YCSRobotics/CAD-66-ROBOT-2018/Reference Pics/SF1.png

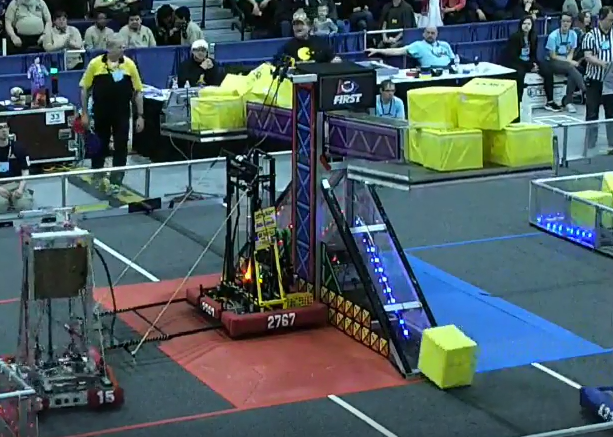
Reference Pics/SF1.png
