YCSRobotics/CAD-66-ROBOT-2018/Reference Pics/SF2.png

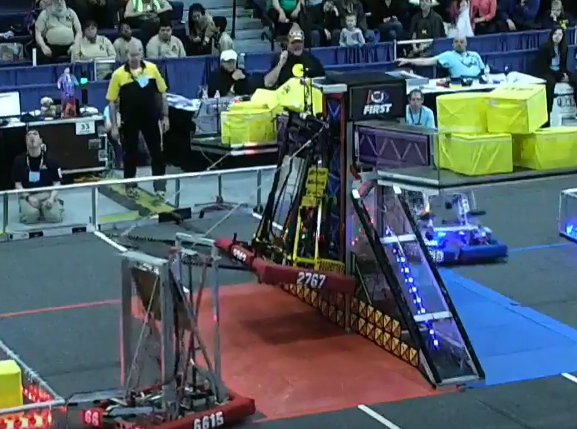
Reference Pics/SF2.png
