YCSRobotics/CAD-66-ROBOT-2018/Part Drawings/All Part Drawings.pdf

# Elevator Base

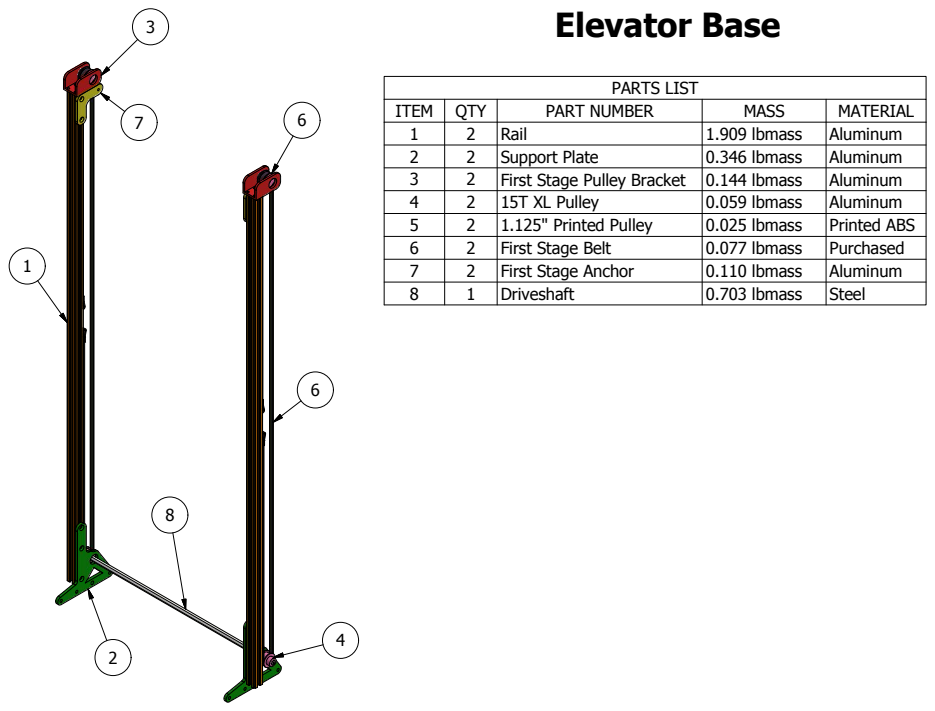
[picture p23: page 1]
PARTS LIST; ITEM; QTY; PART NUMBER; MASS; MATERIAL; Rail; 1.909 lbmass; Aluminum; Support Plate; 0.346 lbmass; First Stage Pulley Bracket; 0.144 lbmass; 15T XL Pulley; 0.059 lbmass; 1.125" Printed Pulley; 0.025 lbmass; Printed ABS; First Stage Belt; 0.077 lbmass; Purchased; First Stage Anchor; 0.110 lbmass; Driveshaft; 0.703 lbmass; Steel

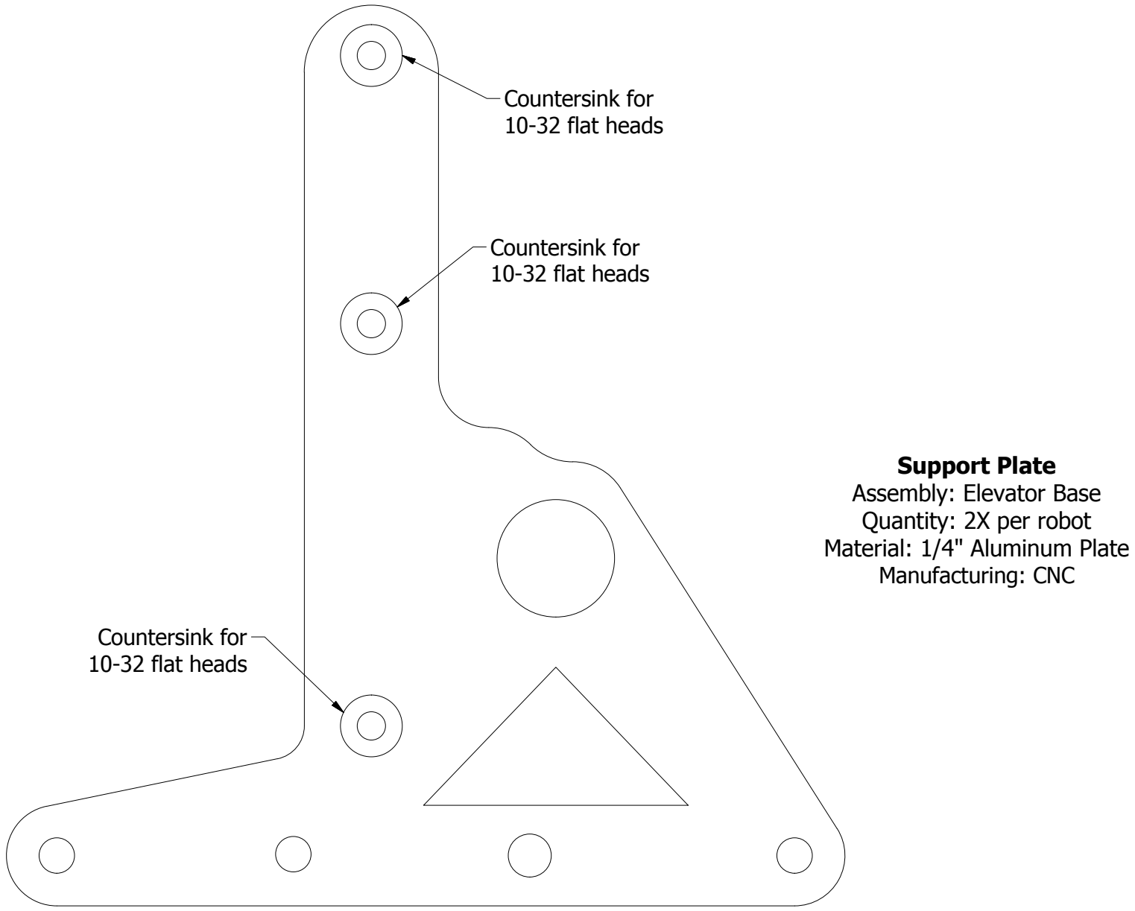
[picture p24: figure]
Countersink for 10-32 flat heads; Support Plate Assembly: Elevator Base Quantity: 2X per robot Material: 1/4" Aluminum Plate Manufacturing: CNC

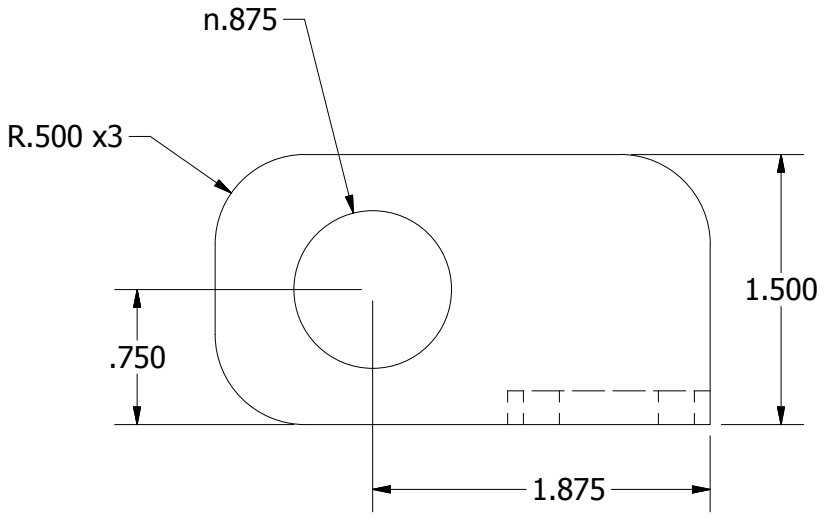
[picture p25: figure]

1.125
3/16 or 1/4

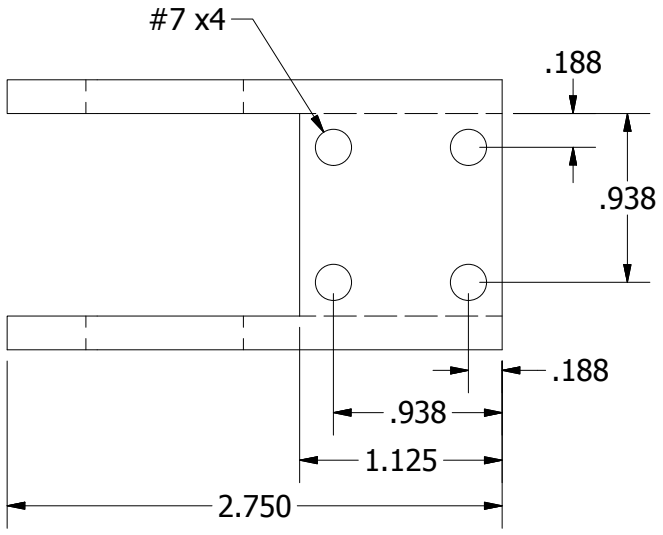
[picture p26: figure]

First Stage Pulley Bracket Assembly: Elevator Base
Quantity: 2X per robot
Material: 3/16" by 1.5" C Channel or 1/4" by 1.625" C Channel Manufacturing: Mill

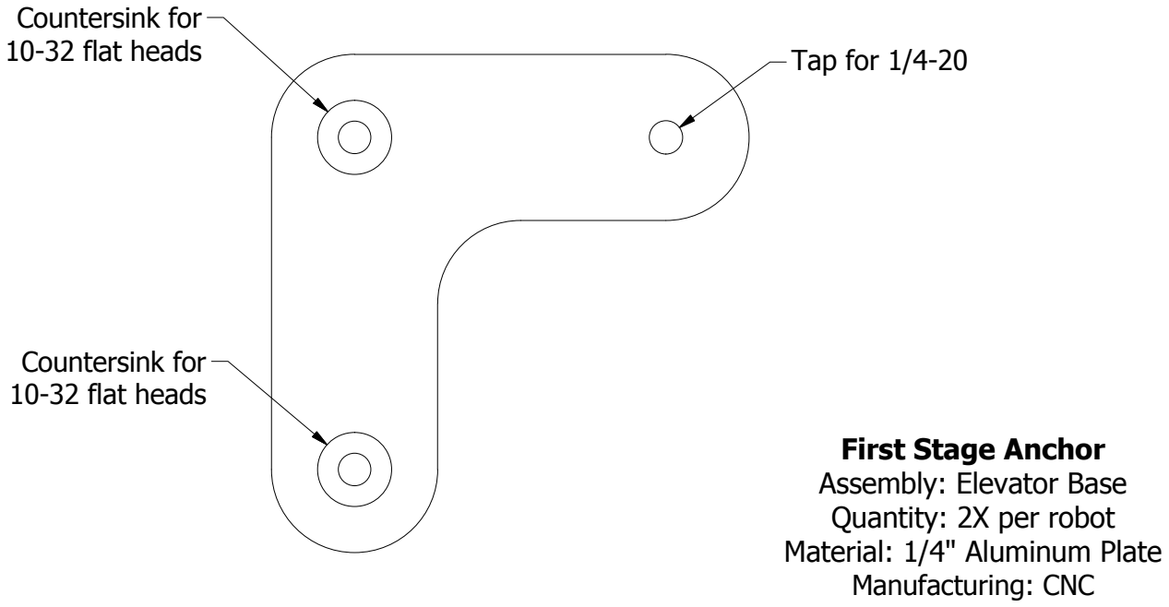
[picture p27: figure]
Countersink for 10-32 flat heads; Tap for 1/4-20; First Stage Anchor Assembly: Elevator Base Quantity: 2X per robot Material: 1/4" Aluminum Plate Manufacturing: CNC

.375 21.750

Driveshaft
Assembly: Elevator Base
Quantity: 2X per robot
Material: 3/8" Steel Hex Shaft Manufacturing: Cut from stock

# First Stage

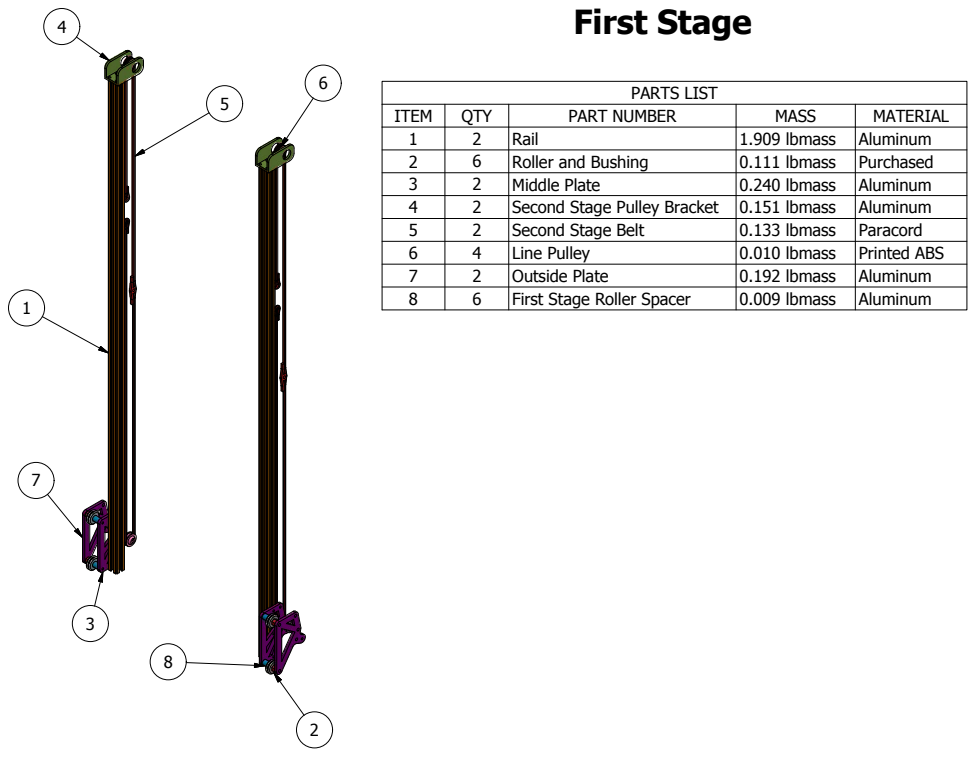
[picture p28: page 6]
PARTS LIST; ITEM; QTY; PART NUMBER; MASS; MATERIAL; Rail; 1.909 lbmass; Aluminum; Roller and Bushing; 0.111 lbmass; Purchased; Middle Plate; 0.240 lbmass; Second Stage Pulley Bracket; 0.151 lbmass; Second Stage Belt; 0.133 lbmass; Paracord; Line Pulley; 0.010 lbmass; Printed ABS; Outside Plate; 0.192 lbmass; First Stage Roller Spacer; 0.009 lbmass

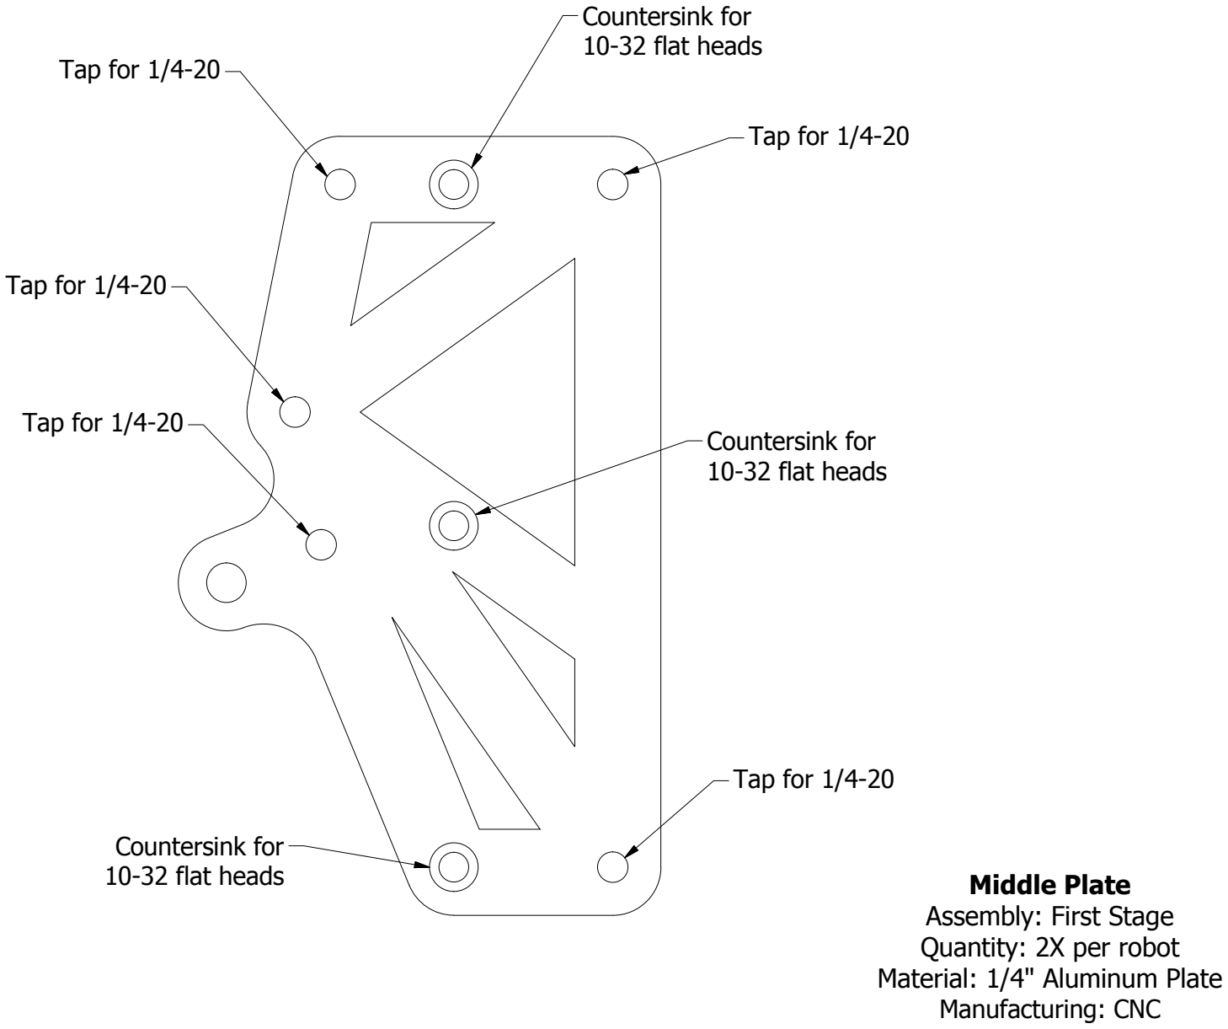
[picture p29: figure]
Tap for 1/4-20; Countersink for 10-32 flat heads; Countersink for; 10-32 flat heads; Middle Plate; Assembly: First Stage Quantity: 2X per robot Material: 1/4" Aluminum Plate Manufacturing: CNC

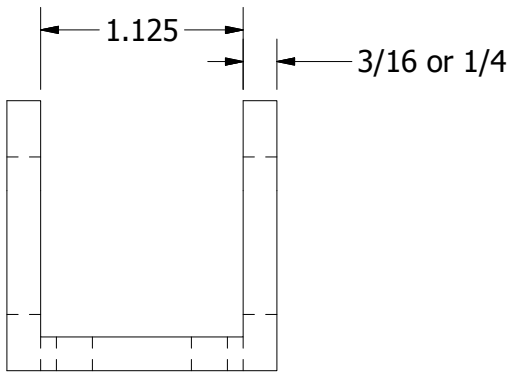
[picture p30: figure]
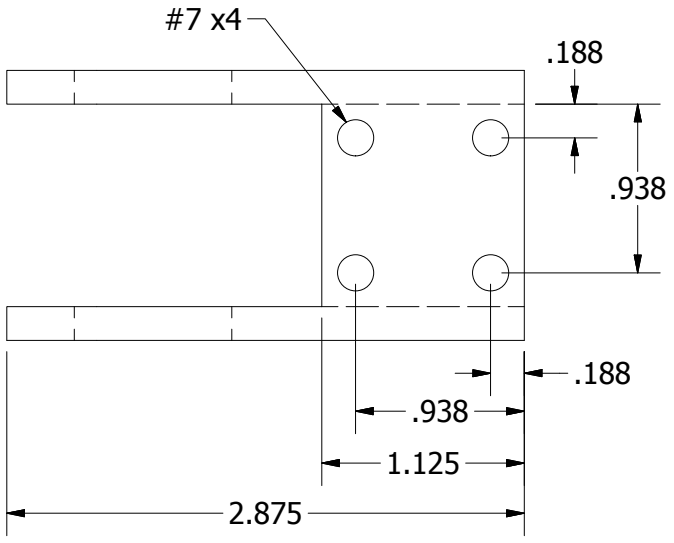
[picture p31: figure]

Second Stage Pulley Bracket Assembly: First Stage
Quantity: 2X per robot
Material: 3/16" by 1.5" C Channel or 1/4" by 1.625" C Channel Manufacturing: Mill

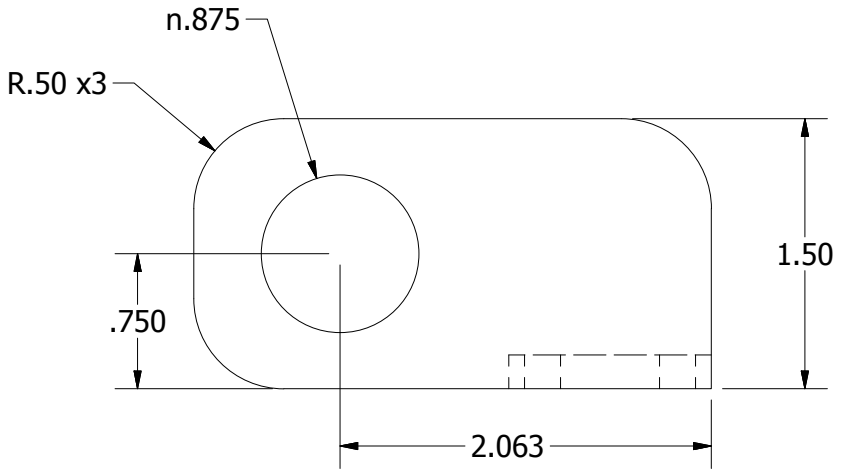
[picture p32: figure]


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
n.260

.657

First Stage Spacer
Assembly: First Stage
Quantity: 6X per robot
Material: Aluminum Anything Manufacturing: lathe

between .500 and .625

# Second Stage

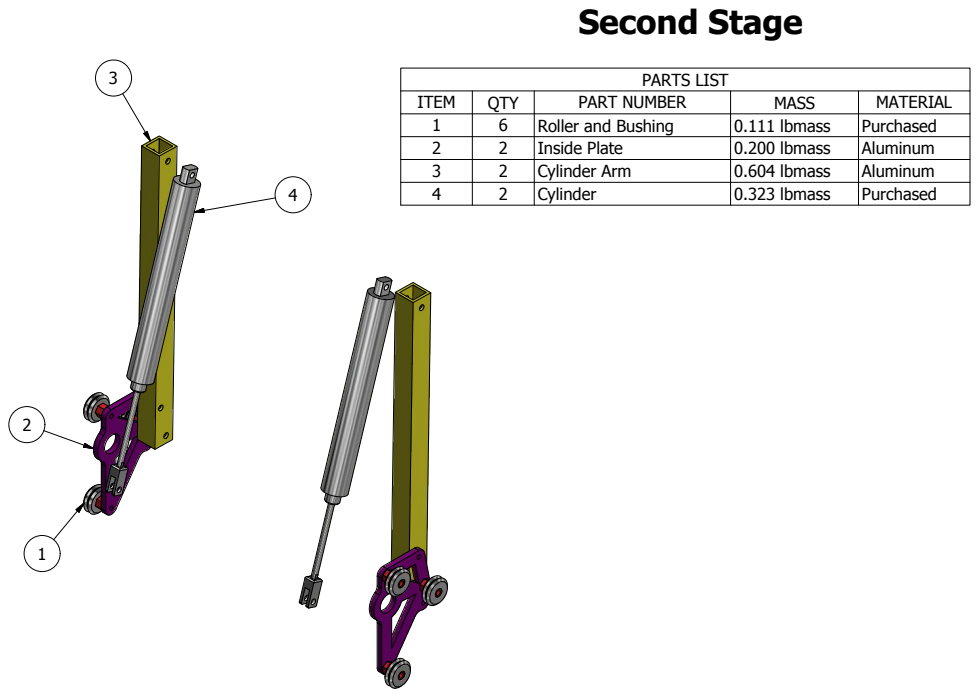
[picture p33: page 11]
PARTS LIST; ITEM; QTY; PART NUMBER; MASS; MATERIAL; Roller and Bushing; 0.111 lbmass; Purchased; Inside Plate; 0.200 lbmass; Aluminum; Cylinder Arm; 0.604 lbmass; Cylinder; 0.323 lbmass

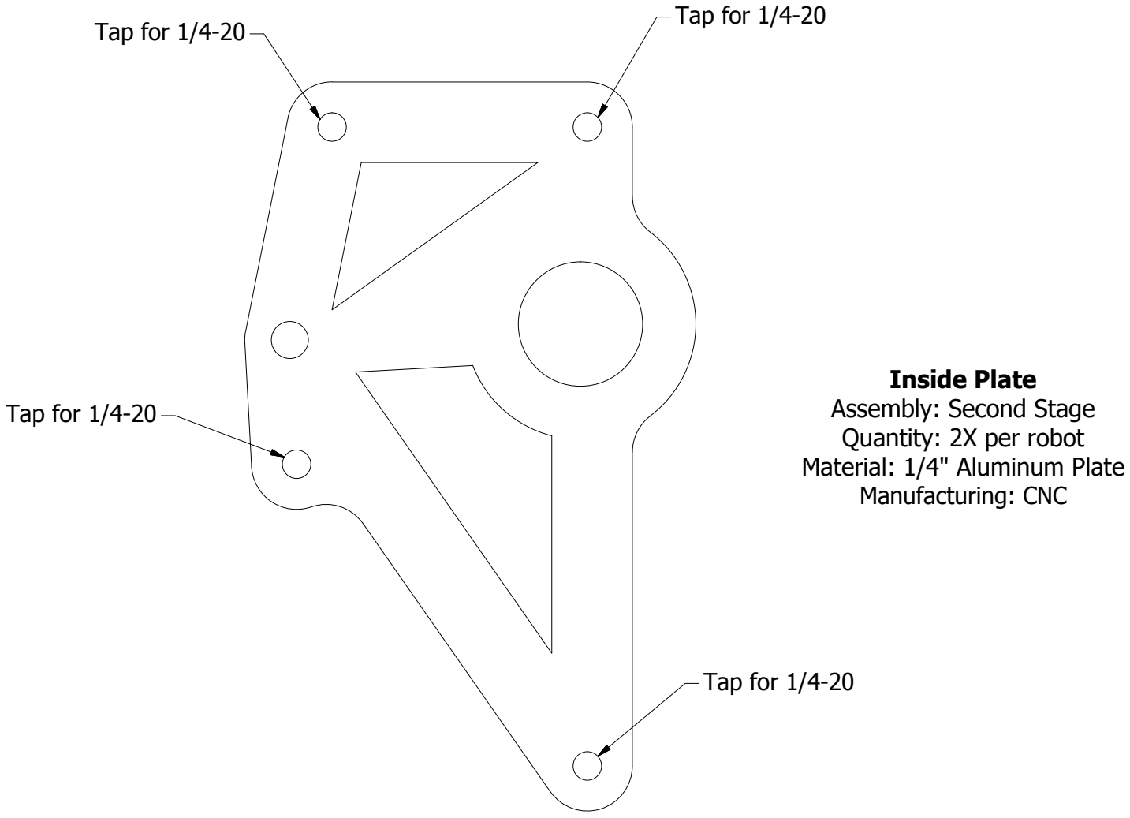
[picture p34: figure]
Tap for 1/4-20; Inside Plate Assembly: Second Stage Quantity: 2X per robot Material: 1/4" Aluminum Plate Manufacturing: CNC

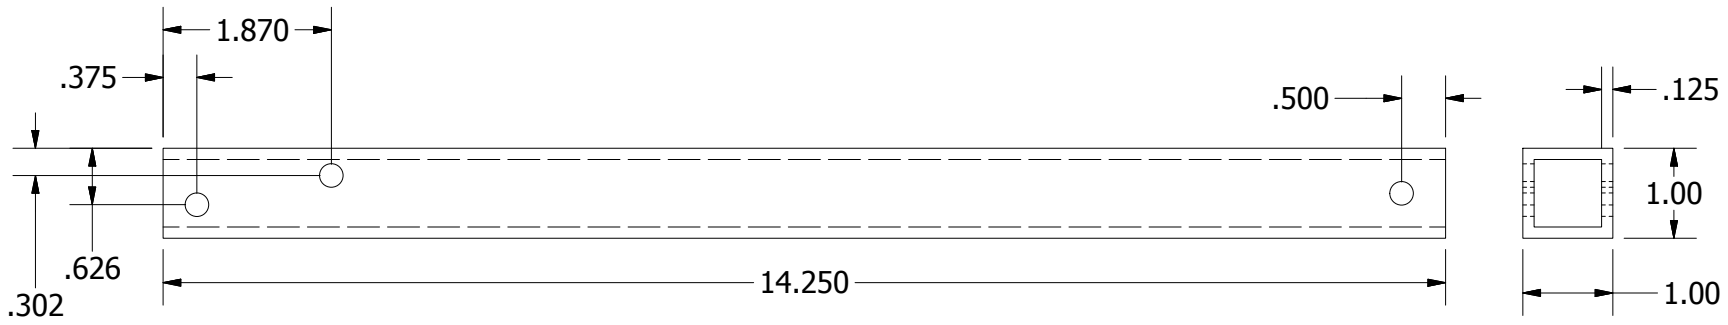
[picture p35: figure]

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
# Cube Intake

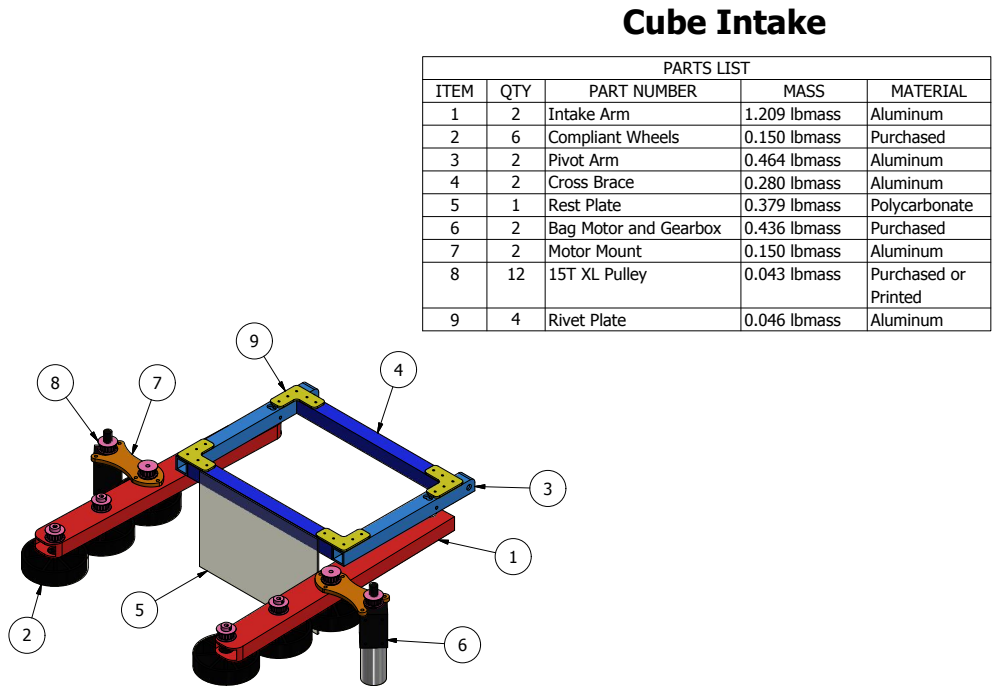
[picture p36: page 14]
PARTS LIST; ITEM; QTY; PART NUMBER; MASS; MATERIAL; Intake Arm; 1.209 lbmass; Aluminum; Compliant Wheels; 0.150 lbmass; Purchased; Pivot Arm; 0.464 lbmass; Cross Brace; 0.280 lbmass; Rest Plate; 0.379 lbmass; Polycarbonate; Bag Motor and Gearbox; 0.436 lbmass; Motor Mount; Purchased or Printed; 15T XL Pulley; 0.043 lbmass; Rivet Plate; 0.046 lbmass

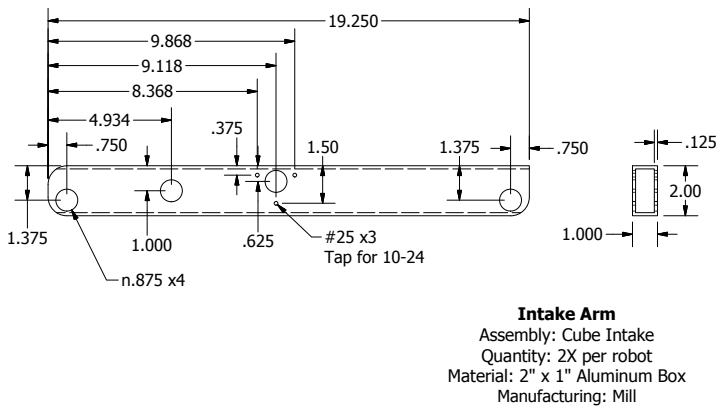
[picture p37: page 15]
Manufacturing: Mill; #25 x3 Tap for 10-24

Intake Arm
Assembly: Cube Intake
Quantity: 2X per robot
Material: 2" x 1" Aluminum Box

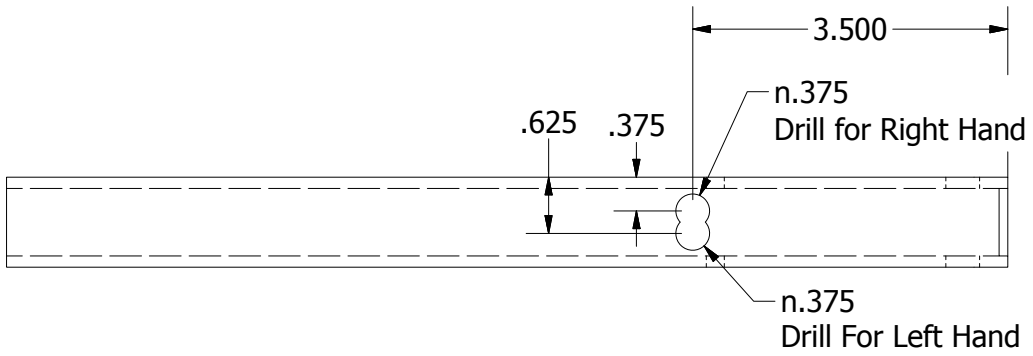
[picture p38: figure]
n.375 Drill for Right Hand; n.375 Drill For Left Hand

1.00

1.00

.125

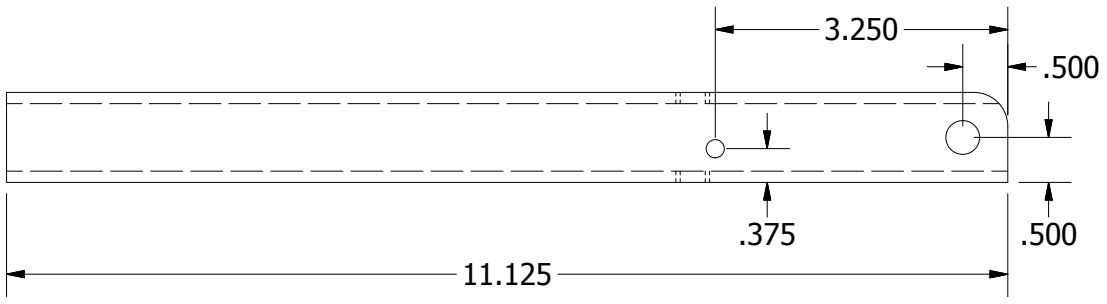
[picture p39: figure]

Pivot Arm
Assembly: Cube Intake
Quantity: One each RH, LH
Material: 1" Aluminum Box
Manufacturing: Mill

12.25

1.00

1.00

.063

Cross Brace
Assembly: Cube Intake
Quantity: 2X per robot
Material: 1" Aluminum Box
Manufacturing: Mill


Rest Plate
Assembly: Cube Intake
Quantity: 1X per robot
Material: 1/8" Polycarbonate Plate Manufacturing: CNC


Motor Mount
Assembly: Cube Intake
Quantity: 2X per robot
Material: 1/4" Aluminum Plate Manufacturing: CNC

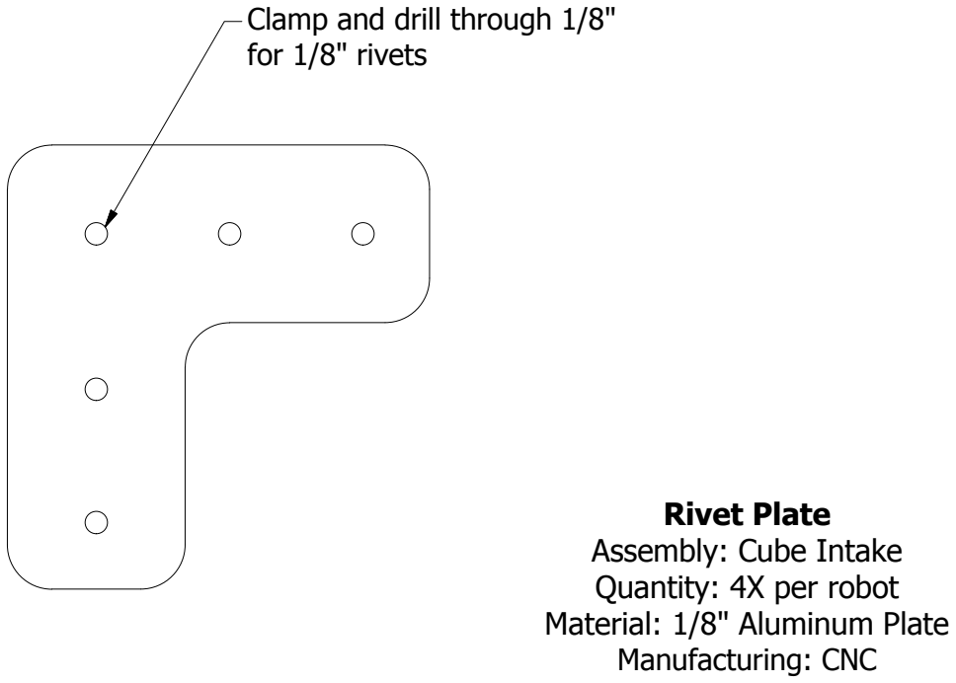
[picture p40: figure]
Rivet Plate Assembly: Cube Intake Quantity: 4X per robot Material: 1/8" Aluminum Plate Manufacturing: CNC; Clamp and drill through 1/8" for 1/8" rivets
