YCSRobotics/CAD-66-ROBOT-2018/Cube Lift/18T XL Pulley.STEP

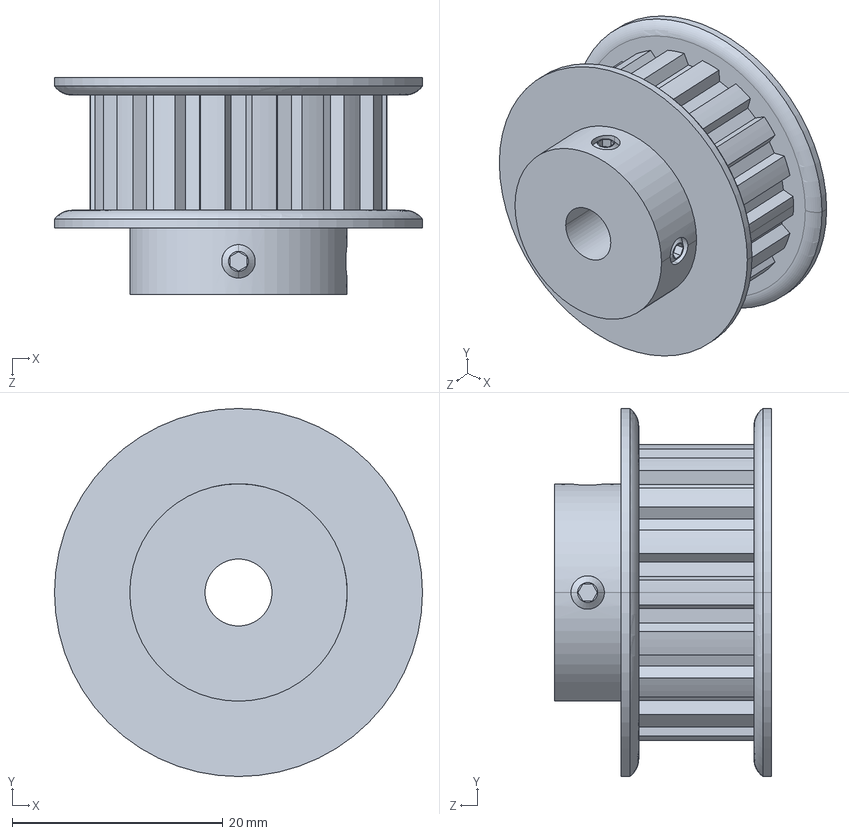
[picture p41: CAD file, 2018-02-03]
Cube Lift/18T XL Pulley.STEP
34.9 x 34.9 x 20.6 mm
