YCSRobotics/CAD-66-ROBOT-2018/Cube Lift/Cut Print/climb slider 1.03.stl

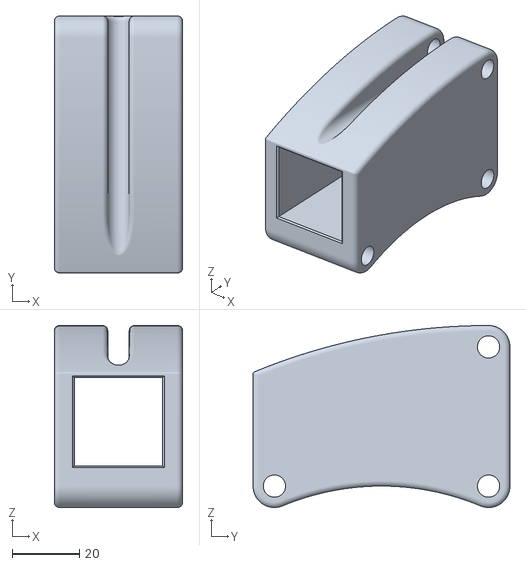
[picture p42: CAD file, 2018-03-28]
Cube Lift/Cut Print/climb slider 1.03.stl
38.1 x 76.2 x 54.0
