YCSRobotics/CAD-66-ROBOT-2018/Cube Lift/Drive motor/VersaPlanetary_CIM_Adapter_217-4018.STEP

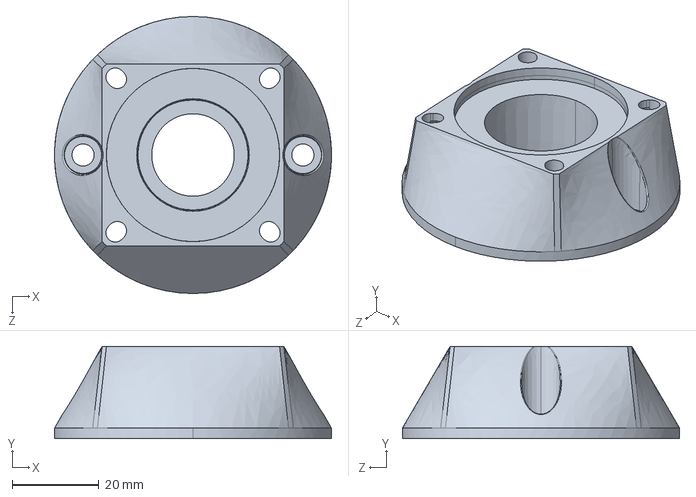
[picture p43: CAD file, 2018-02-03]
Cube Lift/Drive motor/VersaPlanetary_CIM_Adapter_217-4018.STEP
64.0 x 21.4 x 64.0 mm
