YCSRobotics/CAD-66-ROBOT-2018/DXFs for WaterJet/.25PlatesSheet3.dxf

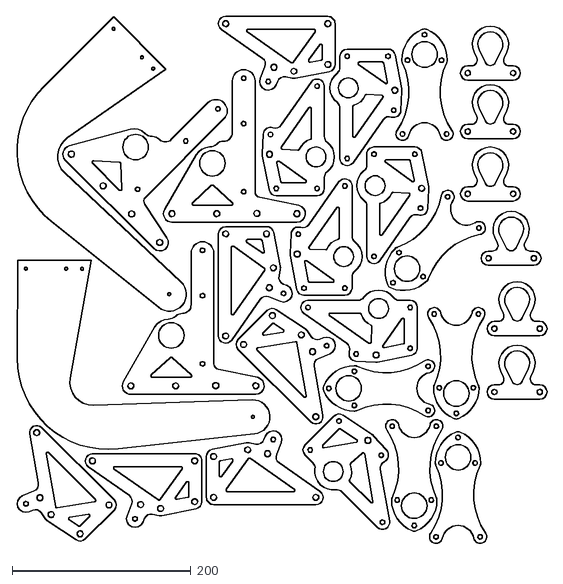
[picture p44: CAD file, 2018-02-02]
DXFs for WaterJet/.25PlatesSheet3.dxf
593.8 x 589.5
