YCSRobotics/CAD-66-ROBOT-2018/DXFs/IntakeArm1.dxf

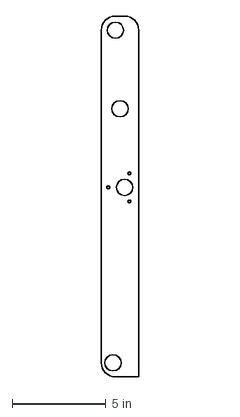
[picture p45: CAD file, 2018-02-08]
DXFs/IntakeArm1.dxf
2.00 x 19.2 in
