YCSRobotics/CAD-66-ROBOT-2018/Part Drawings/Intake Arm.dxf

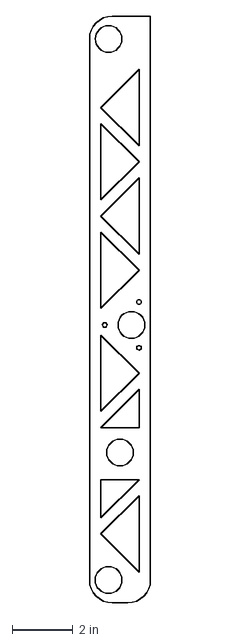
[picture p46: CAD file, 2018-02-08]
Part Drawings/Intake Arm.dxf
2.00 x 19.2 in
