YCSRobotics/CAD-66-ROBOT-2018/Robot Lift mk2 180128/Parts for cut/.125 X plate cut.dxf

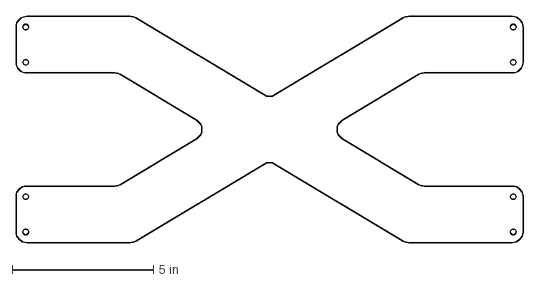
[picture p47: CAD file, 2018-03-28]
Robot Lift mk2 180128/Parts for cut/.125 X plate cut.dxf
17.9 x 8.00 in
