YCSRobotics/CAD-66-ROBOT-2018/STEP/Square Tube Base Frame 180226.stp

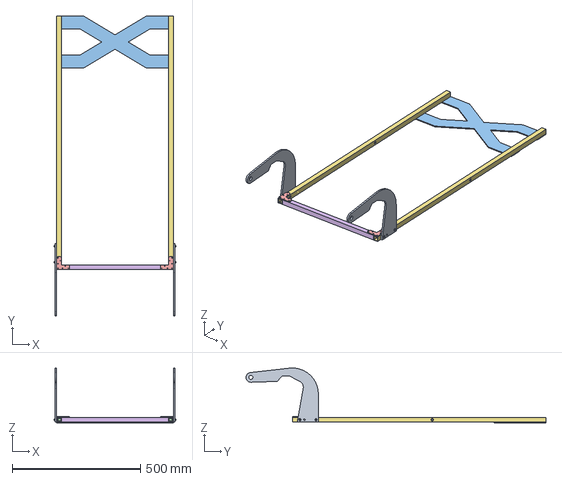
[picture p48: CAD file, 2018-03-28]
STEP/Square Tube Base Frame 180226.stp
475.0 x 1171.6 x 214.8 mm
