YCSRobotics/CAD-66-ROBOT-2018/DXFs for WaterJet/.25PlatesSheet1.dxf

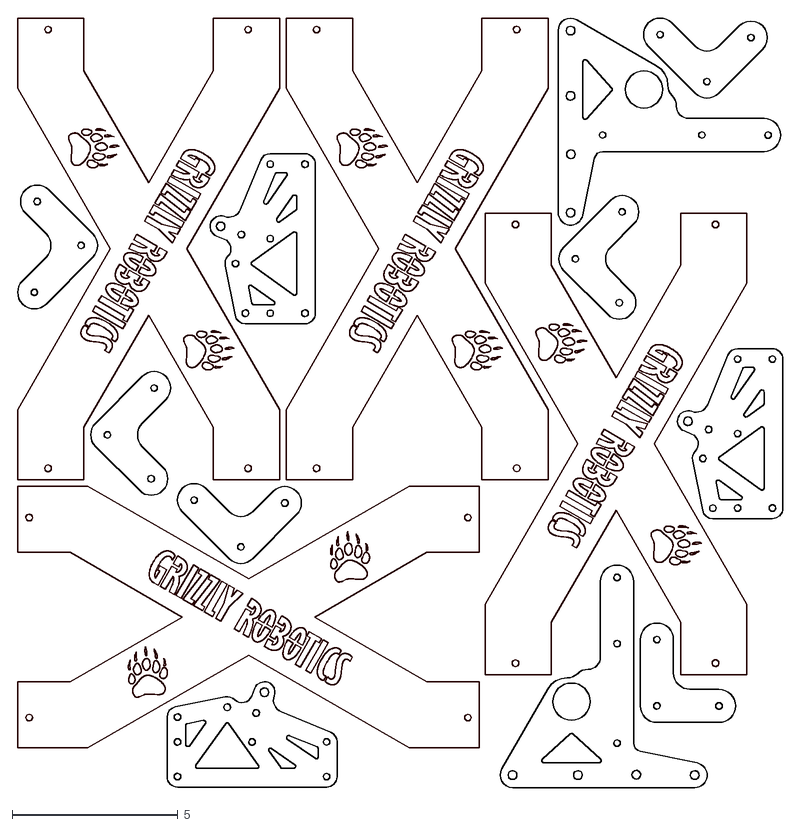
[picture p49: CAD file, 2018-02-02]
DXFs for WaterJet/.25PlatesSheet1.dxf
23.2 x 23.3
