YCSRobotics/CAD-66-ROBOT-2018/DXFs/IntakeArm2.dxf

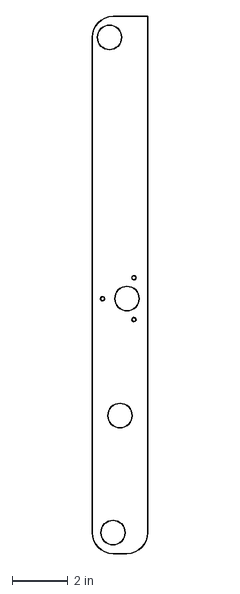
[picture p50: CAD file, 2018-02-08]
DXFs/IntakeArm2.dxf
2.00 x 19.2 in
