YCSRobotics/CAD-66-ROBOT-2018/STEP/Entrapment Star Wheel.SLDPRT

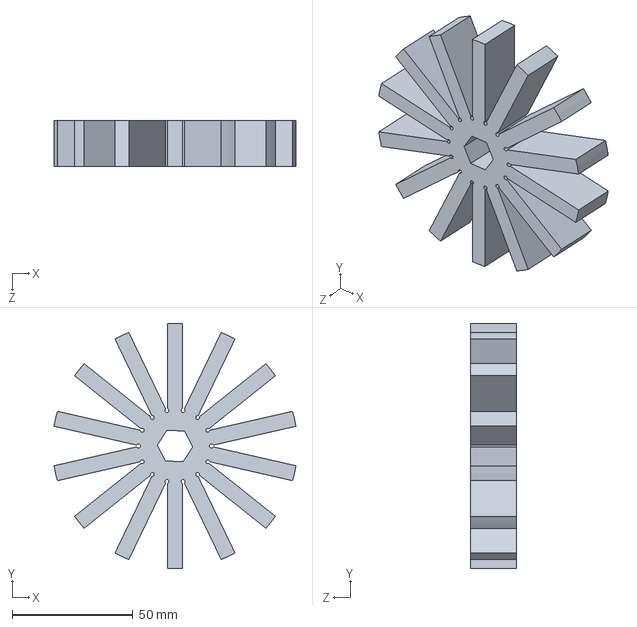
[picture p51: CAD file, 2018-02-12]
STEP/Entrapment Star Wheel.SLDPRT
100.3 x 101.6 x 19.1 mm
