YCSRobotics/CAD-66-ROBOT-2018/DXFs for WaterJet/.125PlatesSheet1.dxf

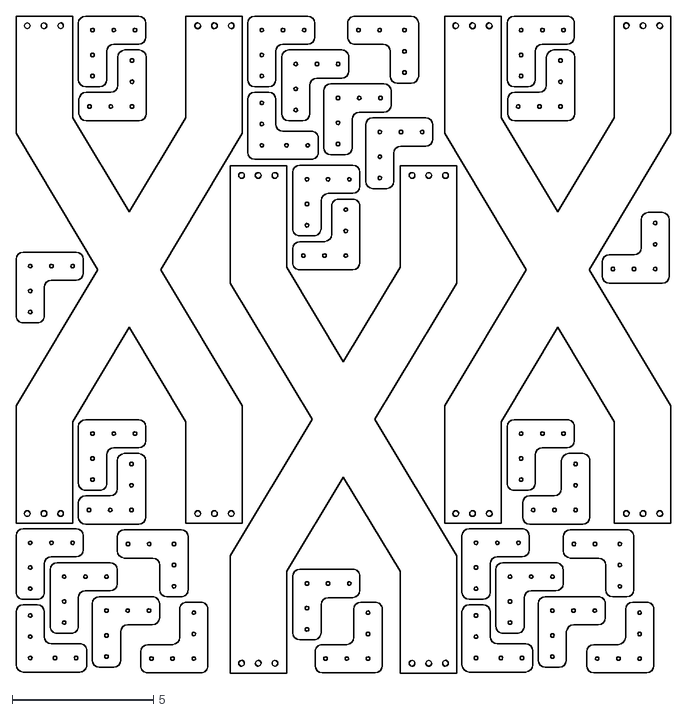
[picture p52: CAD file, 2018-02-02]
DXFs for WaterJet/.125PlatesSheet1.dxf
23.2 x 23.2
