YCSRobotics/CAD-66-ROBOT-2018/Part Drawings/Middle Plate.dxf

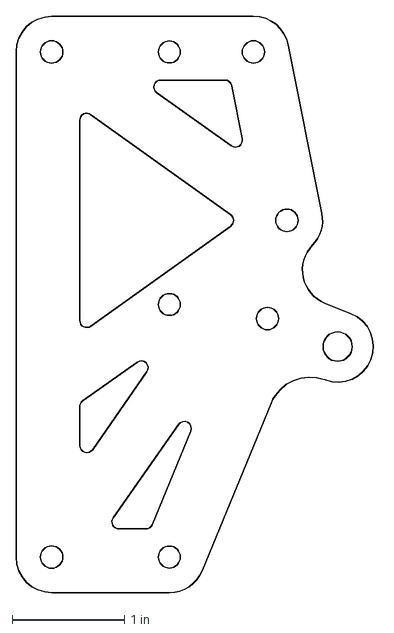
[picture p53: CAD file, 2018-02-07]
Part Drawings/Middle Plate.dxf
3.22 x 5.13 in
