YCSRobotics/CAD-66-ROBOT-2018/Cube Lift/Cut Print/climb pulley.stl

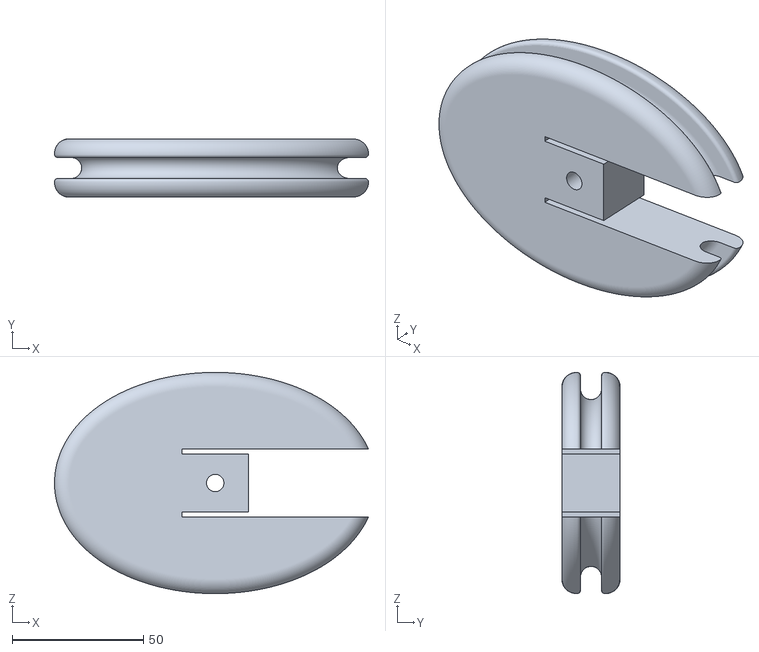
[picture p54: CAD file, 2018-03-28]
Cube Lift/Cut Print/climb pulley.stl
119.4 x 22.2 x 84.1
