YCSRobotics/CAD-66-ROBOT-2018/DXFs for WaterJet/.25PlatesSheet2.dxf

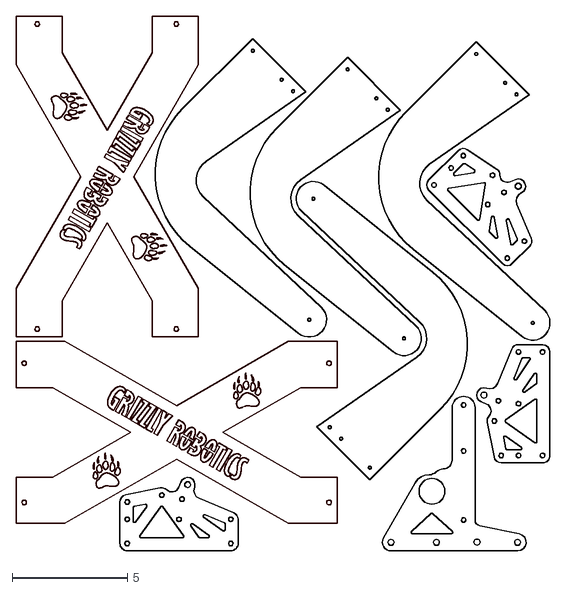
[picture p55: CAD file, 2018-02-02]
DXFs for WaterJet/.25PlatesSheet2.dxf
23.3 x 23.2
