YCSRobotics/CAD-66-ROBOT-2018/Part Drawings/RobotLiftTopXPlate.dxf

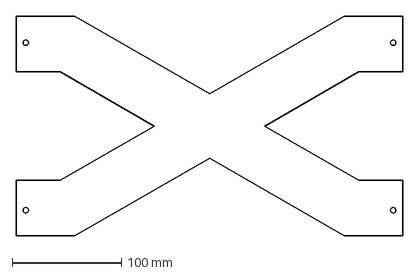
[picture p56: CAD file, 2018-02-02]
Part Drawings/RobotLiftTopXPlate.dxf
354.1 x 200.8 mm
