YCSRobotics/CAD-66-ROBOT-2018/Cube Lift/Cut Print/hook.dxf

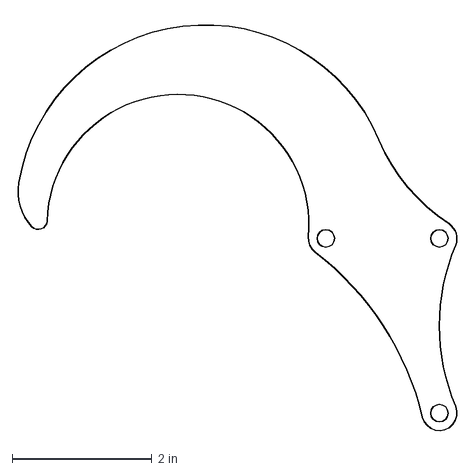
[picture p57: CAD file, 2018-03-28]
Cube Lift/Cut Print/hook.dxf
6.33 x 5.94 in
