YCSRobotics/CAD-66-ROBOT-2018/DXFs/RobotLiftHinge.dxf

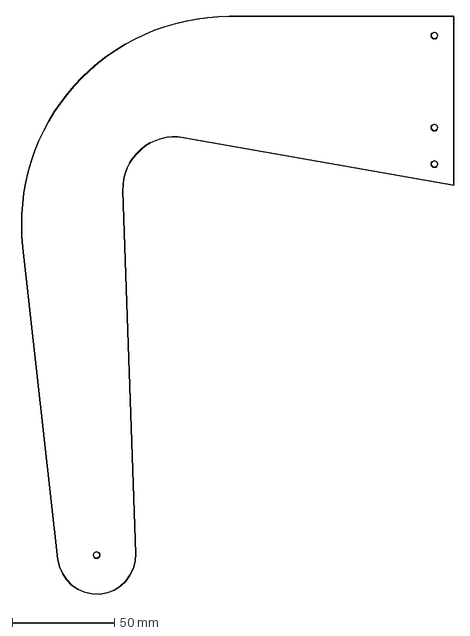
[picture p59: CAD file, 2018-02-02]
DXFs/RobotLiftHinge.dxf
214.1 x 283.3 mm
