YCSRobotics/CAD-66-ROBOT-2018/Part Drawings/Inside Plate.dxf

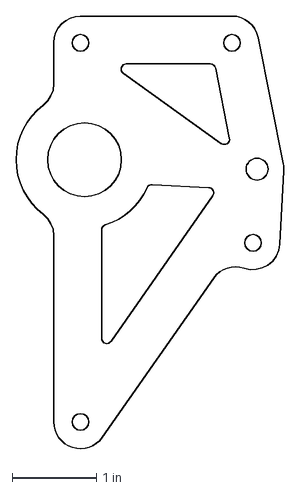
[picture p60: CAD file, 2018-02-02]
Part Drawings/Inside Plate.dxf
3.18 x 5.16 in
