YCSRobotics/CAD-66-ROBOT-2018/DXFs/RobotLiftBottomXPlate.dxf

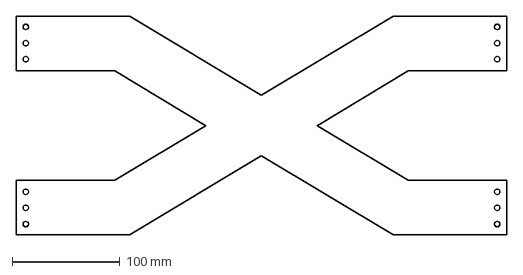
[picture p61: CAD file, 2018-02-02]
DXFs/RobotLiftBottomXPlate.dxf
455.7 x 203.2 mm
