YCSRobotics/CAD-66-ROBOT-2018/Part Drawings/Outside Plate.dxf

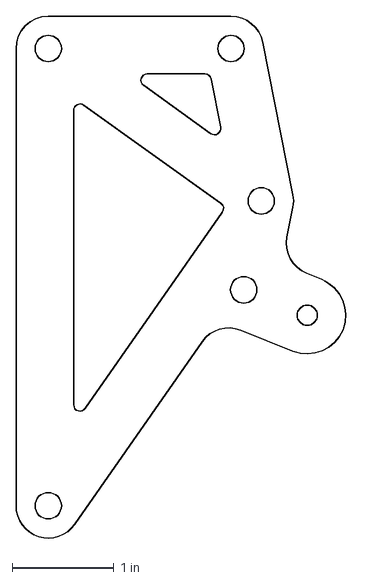
[picture p62: CAD file, 2018-02-02]
Part Drawings/Outside Plate.dxf
3.30 x 5.16 in
