YCSRobotics/CAD-66-ROBOT-2018/Part Drawings/LiftingEye.dxf

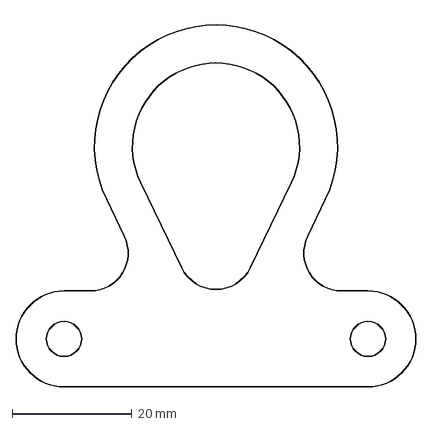
[picture p63: CAD file, 2018-02-02]
Part Drawings/LiftingEye.dxf
66.8 x 62.0 mm
