YCSRobotics/CAD-66-ROBOT-2018/Part Drawings/Rivet Plate.dxf

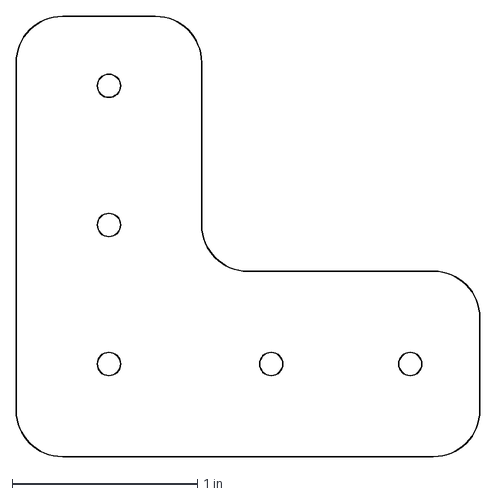
[picture p64: CAD file, 2018-01-30]
Part Drawings/Rivet Plate.dxf
2.50 x 2.38 in
