YCSRobotics/CAD-66-ROBOT-2018/DXFs/First Stage Anchor.dxf

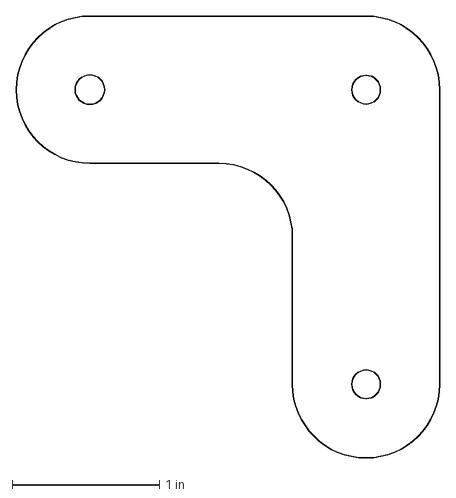
[picture p65: CAD file, 2018-01-30]
DXFs/First Stage Anchor.dxf
2.88 x 3.00 in
