YCSRobotics/CAD-66-ROBOT-2018/Part Drawings/Rest Plate.dxf

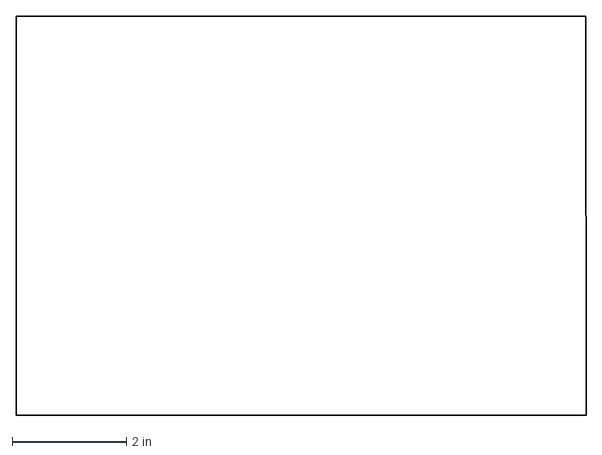
[picture p66: CAD file, 2018-01-30]
Part Drawings/Rest Plate.dxf
10.0 x 7.00 in
