YCSRobotics/CAD-66-ROBOT-2018/DXFs/Motor Mount.dxf

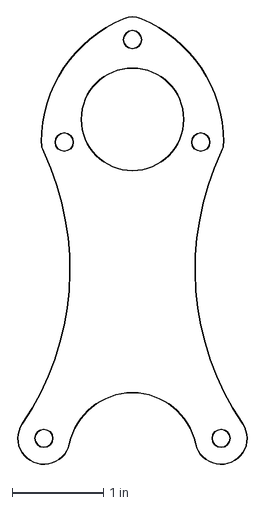
[picture p67: CAD file, 2018-01-30]
DXFs/Motor Mount.dxf
2.55 x 4.93 in
