YCSRobotics/CAD-66-ROBOT-2018/(list of files, cad)

Other CAD files:
Cube Lift/Cut Print/climb slider 1.02.stl
Part Drawings/Part Drawings.dwg
Cube Lift/Cut Print/climb slider.stl
Part Drawings/Support Plate.dxf
DXFs/Support Plate.dxf
Chassis/2018_chassis.iam
Chassis/250x1000 dowel.ipt
Chassis/FR8ZZ Hex Bearing.ipt
Chassis/OldVersions/2018_chassis.0005.iam
Chassis/OldVersions/250x1000 dowel.0001.ipt
Chassis/OldVersions/FR8ZZ Hex Bearing.0001.ipt
Chassis/OldVersions/R6ZZ Bearing.0001.ipt
Chassis/OldVersions/TM Housing.0001.ipt
Chassis/OldVersions/am-0255+2.5inch+CIM+Motor.0001.ipt
Chassis/OldVersions/am-0801a+Toughbox+Long+Hex+Shaft+With+Magnet.0002.iam
Chassis/OldVersions/am-2951a_AM14U3_Outside_Plate.0001.ipt
Chassis/OldVersions/am-2952a_AM14U3_Inside_Plate.0001.ipt
Chassis/OldVersions/am-3513+AM14U3+End+Plate+27in.0001.ipt
Chassis/OldVersions/bumpers.0001.ipt
Chassis/OldVersions/inner_rail_support.0001.ipt
Chassis/OldVersions/ip-0801a Toughbox Long Hex Output Shaft.0001.ipt
Chassis/OldVersions/omni wheel.0002.ipt
Chassis/R6ZZ Bearing.ipt
Chassis/TM Housing.ipt
Chassis/am-0255+2.5inch+CIM+Motor.ipt
Chassis/am-0801a+Toughbox+Long+Hex+Shaft+With+Magnet.iam
Chassis/am-2951a_AM14U3_Outside_Plate.ipt
Chassis/am-2952a_AM14U3_Inside_Plate.ipt
Chassis/am-3513+AM14U3+End+Plate+27in.ipt
Chassis/bumpers.ipt
Chassis/inner_rail_support.ipt
Chassis/ip-0801a Toughbox Long Hex Output Shaft.ipt
Chassis/omni wheel.ipt
Cube Intake V2 (pre relaese)/1277N450_CORROSION-RESISTANT TIMING BELT PULLEY.ipt
Cube Intake V2 (pre relaese)/15t hex 3.8 shaft short.ipt
Cube Intake V2 (pre relaese)/15t hex 3.8 shaft.ipt
Cube Intake V2 (pre relaese)/Intake V2 2.iam
Cube Intake V2 (pre relaese)/Intake V2.iam
Cube Intake V2 (pre relaese)/OldVersions/1277N450_CORROSION-RESISTANT TIMING BELT PULLEY.0001.ipt
Cube Intake V2 (pre relaese)/OldVersions/15t hex 3.8 shaft.0001.ipt
Cube Intake V2 (pre relaese)/OldVersions/Intake 2.0010.iam
Cube Intake V2 (pre relaese)/OldVersions/Intake V2 2.0001.iam
Cube Intake V2 (pre relaese)/OldVersions/Intake V2.0011.iam
Cube Intake V2 (pre relaese)/OldVersions/Intake.0017.iam
Cube Intake V2 (pre relaese)/OldVersions/Part69.0004.ipt
Cube Intake V2 (pre relaese)/OldVersions/Roller drive shaft.0001.ipt
Cube Intake V2 (pre relaese)/OldVersions/angle bracket.0002.ipt
Cube Intake V2 (pre relaese)/OldVersions/arm.0014.ipt
Cube Intake V2 (pre relaese)/OldVersions/cross brace.0004.ipt
Cube Intake V2 (pre relaese)/OldVersions/intake roller.0002.ipt
Cube Intake V2 (pre relaese)/OldVersions/micro cim.0003.ipt
Cube Intake V2 (pre relaese)/OldVersions/motor mount.0004.ipt
Cube Intake V2 (pre relaese)/OldVersions/pivot arm.0011.ipt
Cube Intake V2 (pre relaese)/OldVersions/pivot block.0003.ipt
Cube Intake V2 (pre relaese)/OldVersions/pivot plate.0001.ipt
Cube Intake V2 (pre relaese)/OldVersions/plate.0002.ipt
Cube Intake V2 (pre relaese)/OldVersions/rest plate.0002.ipt
Cube Intake V2 (pre relaese)/OldVersions/top bracket.0002.ipt
Cube Intake V2 (pre relaese)/Part69.ipt
Cube Intake V2 (pre relaese)/Roller drive shaft.ipt
Cube Intake V2 (pre relaese)/Roller shaft.ipt
Cube Intake V2 (pre relaese)/arm.ipt
Cube Intake V2 (pre relaese)/cross brace.ipt
Cube Intake V2 (pre relaese)/intake roller.ipt
Cube Intake V2 (pre relaese)/micro cim.ipt
Cube Intake V2 (pre relaese)/pivot arm.ipt
Cube Intake V2 (pre relaese)/plate.ipt
Cube Intake V2 (pre relaese)/rest plate.ipt
Cube Intake V2/1277N450_CORROSION-RESISTANT TIMING BELT PULLEY.ipt
Cube Intake V2/15t hex 3.8 shaft short.ipt
Cube Intake V2/15t hex 3.8 shaft.ipt
Cube Intake V2/Intake V2 2.iam
Cube Intake V2/Intake V2.iam
Cube Intake V2/OldVersions/1277N450_CORROSION-RESISTANT TIMING BELT PULLEY.0001.ipt
Cube Intake V2/OldVersions/15t hex 3.8 shaft.0001.ipt
Cube Intake V2/OldVersions/Intake 2.0010.iam
Cube Intake V2/OldVersions/Intake V2 2.0001.iam
Cube Intake V2/OldVersions/Intake V2.0011.iam
Cube Intake V2/OldVersions/Intake.0017.iam
Cube Intake V2/OldVersions/Part69.0004.ipt
Cube Intake V2/OldVersions/Roller drive shaft.0001.ipt
Cube Intake V2/OldVersions/angle bracket.0002.ipt
Cube Intake V2/OldVersions/arm.0014.ipt
Cube Intake V2/OldVersions/cross brace.0004.ipt
Cube Intake V2/OldVersions/intake roller.0002.ipt
Cube Intake V2/OldVersions/micro cim.0003.ipt
Cube Intake V2/OldVersions/motor mount.0004.ipt
Cube Intake V2/OldVersions/pivot arm.0011.ipt
Cube Intake V2/OldVersions/pivot block.0003.ipt
Cube Intake V2/OldVersions/pivot plate.0001.ipt
Cube Intake V2/OldVersions/plate.0002.ipt
Cube Intake V2/OldVersions/rest plate.0002.ipt
Cube Intake V2/OldVersions/top bracket.0002.ipt
Cube Intake V2/Part69.ipt
Cube Intake V2/Roller drive shaft.ipt
Cube Intake V2/Roller shaft.ipt
Cube Intake V2/arm.ipt
Cube Intake V2/cross brace.ipt
Cube Intake V2/intake roller.ipt
Cube Intake V2/micro cim.ipt
Cube Intake V2/pivot arm.ipt
Cube Intake V2/plate.ipt
Cube Intake V2/rest plate.ipt
Cube Intake/1277N450_CORROSION-RESISTANT TIMING BELT PULLEY.STEP
Cube Intake/1277N450_CORROSION-RESISTANT TIMING BELT PULLEY.ipt
Cube Intake/Intake 2.iam
Cube Intake/OldVersions/1277N450_CORROSION-RESISTANT TIMING BELT PULLEY.0003.ipt
Cube Intake/OldVersions/Intake 2.0022.iam
Cube Intake/OldVersions/Roller drive shaft.0003.ipt
Cube Intake/OldVersions/Roller drive shaft.0005.ipt
Cube Intake/OldVersions/Roller drive shaft.0007.ipt
Cube Intake/OldVersions/Roller driven shaft.0002.ipt
Cube Intake/OldVersions/Roller shaft.0003.ipt
Cube Intake/OldVersions/Roller shaft.0007.ipt
Cube Intake/OldVersions/arm.0011.ipt
Cube Intake/OldVersions/arm.0022.ipt
Cube Intake/OldVersions/cross brace.0003.ipt
Cube Intake/OldVersions/pivot arm.0010.ipt
Cube Intake/Roller drive shaft.ipt
Cube Intake/Roller shaft.ipt
Cube Intake/arm.ipt
Cube Lift/18T XL Pulley.ipt
Cube Lift/Climber.iam
Cube Lift/Cylinder.iam
Cube Lift/Drive motor/217-2625-003 Rev1.ipt
Cube Lift/Drive motor/217-2625-005 Rev1_Planet_Revolving_Follower01.ipt
Cube Lift/Drive motor/217-2625-007 Rev1_Public.ipt
Cube Lift/Drive motor/217-2625-008 Rev1.ipt
Cube Lift/Drive motor/217-2625-010 Rev1.ipt
Cube Lift/Drive motor/217-2625-012 Rev1.ipt
Cube Lift/Drive motor/217-2625-017 Rev1_9714K61.ipt
Cube Lift/Drive motor/217-2625-018 Rev1_98541A410.ipt
Cube Lift/Drive motor/217-2625-025 Rev1.ipt
Cube Lift/Drive motor/217-2625-026 Rev1.ipt
Cube Lift/Drive motor/217-2625-100.iam
Cube Lift/Drive motor/217-2742-001 Rev4.ipt
Cube Lift/Drive motor/217-2816-001 Rev1.ipt
Cube Lift/Drive motor/217-2820 Rev1_Public.iam
Cube Lift/Drive motor/217-2822-001 Rev4.ipt
Cube Lift/Drive motor/217-4649-001 Rev1.ipt
Cube Lift/Drive motor/217-4649-002 Rev1_SSA0832-0500ZC.ipt
Cube Lift/Drive motor/217-4649-005 Rev1_SSA0003-008BA.ipt
Cube Lift/Drive motor/217-4649-007 Rev1_94105A824.ipt
Cube Lift/Drive motor/832-1750-Ring-Gear-Screw_SSA0832-0500ZC.ipt
Cube Lift/Drive motor/BaneBots RS550.ipt
Cube Lift/Drive motor/OldVersions/217-2625-100.0001.iam
Cube Lift/Drive motor/OldVersions/217-2820 Rev1_Public.0001.iam
Cube Lift/Drive motor/OldVersions/VersaPlanetary_v2_Single_Stage_10_1_with_RS_550.0001.iam
Cube Lift/Drive motor/VersaPlanetary_CIM_Adapter_217-4018.ipt
Cube Lift/Drive motor/VersaPlanetary_v2_Single_Stage_10_1_with_RS_550.iam
Cube Lift/Drive motor/am-0255+2.5inch+CIM+Motor.ipt
Cube Lift/Elevator Base.iam
Cube Lift/Elevator and Intake.iam
Cube Lift/First Stage.iam
Cube Lift/Lift 2.iam
Cube Lift/OldVersions/18T XL Pulley.0003.ipt
Cube Lift/OldVersions/18T XL Pulley.0005.ipt
Cube Lift/OldVersions/Climber.0005.iam
Cube Lift/OldVersions/Elevator Base.0004.iam
Cube Lift/OldVersions/Elevator and Intake.0007.iam
Cube Lift/OldVersions/First Stage.0003.iam
Cube Lift/OldVersions/Lift 2.0018.iam
Cube Lift/OldVersions/Lift 2.0027.iam
Cube Lift/OldVersions/Lift 3.0005.iam
Cube Lift/OldVersions/Lift.0017.iam
Cube Lift/OldVersions/Rail.0003.ipt
Cube Lift/OldVersions/Second Stage.0002.iam
Cube Lift/OldVersions/bushing.0005.ipt
Cube Lift/OldVersions/carriage plate for intake.0019.ipt
Cube Lift/OldVersions/carriage plate square 2.0016.ipt
Cube Lift/OldVersions/carriage plate square.0003.ipt
Cube Lift/OldVersions/carriage plate.0003.ipt
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
