YCSRobotics/CAD-66-ROBOT-2018/Part Drawings/All Part Drawings R3.pdf

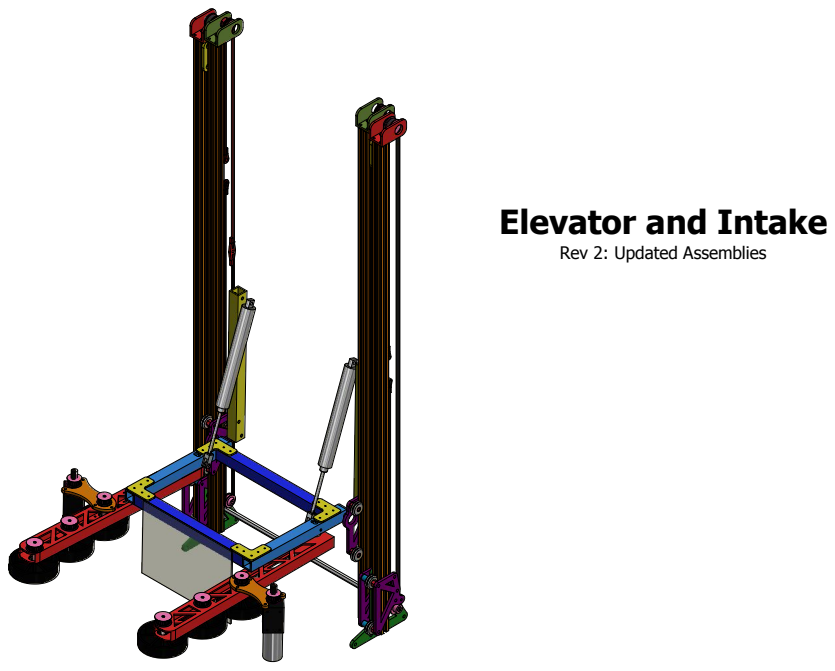
[picture p78: page 1]

Elevator and Intake

Rev 2: Updated Assemblies

# Elevator Base

PARTS LIST; ITEM; QTY; PART NUMBER; MASS; MATERIAL; Rail; 1.909 lbmass; Aluminum; Support Plate; 0.131 lbmass; First Stage Pulley Bracket; 0.144 lbmass; 15T XL Pulley; 0.059 lbmass; 1.125" Printed Pulley; 0.025 lbmass; Printed ABS; First Stage Belt; 0.077 lbmass; Purchased; First Stage Anchor; 0.110 lbmass; Driveshaft; 0.703 lbmass; Steel

Rev 2: Updated support plate

Support Plate Assembly: Elevator Base Quantity: 2X per robot Material: 1/4" Aluminum Plate Manufacturing: CNC Rev 2: Updated hole diameter; Chamfer for 10-32 flat head X3; Rev 2
Rev 1

First Stage Pulley Bracket
Assembly: Elevator Base
Quantity: 2X per robot
Material: 3/16" by 1.5" C Channel
or 1/4" by 1.625" C Channel
Manufacturing: Mill

Chamfer for 10-32 flat head Rev 2; Tap for 1/4-20; First Stage Anchor Assembly: Elevator Base Quantity: 2X per robot Material: 1/4" Aluminum Plate Manufacturing: CNC Rev 2: Updated labels

.375 21.750

Driveshaft
Assembly: Elevator Base
Quantity: 2X per robot
Material: 3/8" Steel Hex Shaft Manufacturing: Cut from stock Rev 1

# First Stage

PARTS LIST; ITEM; QTY; PART NUMBER; MASS; MATERIAL; Rail; 1.909 lbmass; Aluminum; Roller and Bushing; 0.111 lbmass; Purchased; Middle Plate; 0.089 lbmass; Second Stage Pulley Bracket; 0.151 lbmass; Second Stage Belt; 0.133 lbmass; Paracord; Line Pulley; 0.010 lbmass; Printed ABS; Outside Plate; 0.192 lbmass; First Stage Roller Spacer; 0.009 lbmass; Rev 1


Middle Plate
Assembly: First Stage
Quantity: 2X per robot
Material: 1/4" Aluminum Plate Manufacturing: CNC
Rev 1

Rev 1

Second Stage Pulley Bracket
Assembly: First Stage
Quantity: 2X per robot
Material: 3/16" by 1.5" C Channel
or 1/4" by 1.625" C Channel
Manufacturing: Mill


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
n.260

.657

First Stage Spacer
Assembly: First Stage
Quantity: 6X per robot
Material: Aluminum Anything Manufacturing: lathe
Rev 1

between .500 and .625

# Second Stage

PARTS LIST; ITEM; QTY; PART NUMBER; MASS; MATERIAL; Roller and Bushing; 0.111 lbmass; Purchased; Inside Plate; 0.074 lbmass; Aluminum; Cylinder Arm; 0.604 lbmass; Cylinder; 0.323 lbmass

Rev 2: Updated cylinder arm drawing


Inside Plate
Assembly: Second Stage
Quantity: 2X per robot
Material: 1/4" Aluminum Plate Manufacturing: CNC
Rev 1

ill 1

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
ill Rev 3: Changed hole def i

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
# Cube Intake

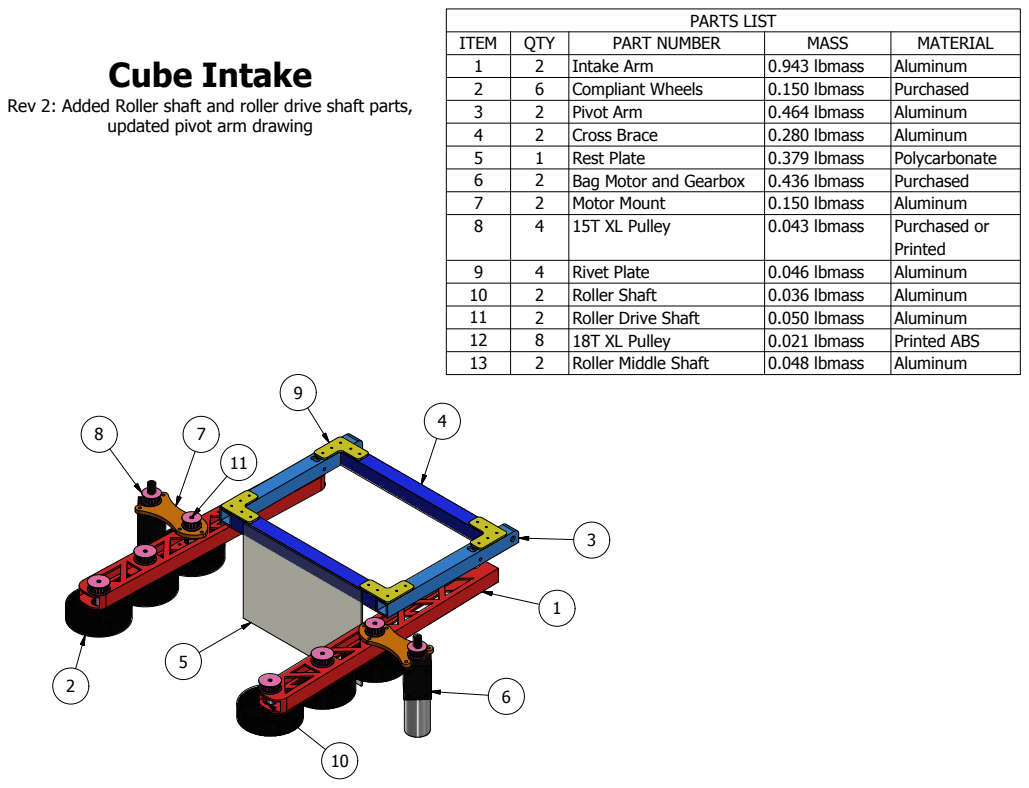
[picture p79: page 15]
PARTS LIST; ITEM; QTY; PART NUMBER; MASS; MATERIAL; Intake Arm; 0.943 lbmass; Aluminum; Compliant Wheels; 0.150 lbmass; Purchased; Pivot Arm; 0.464 lbmass; Cross Brace; 0.280 lbmass; Rest Plate; 0.379 lbmass; Polycarbonate; Bag Motor and Gearbox; 0.436 lbmass; Motor Mount; Purchased or Printed; 15T XL Pulley; 0.043 lbmass; Rivet Plate; 0.046 lbmass; Roller Shaft; 0.036 lbmass; Roller Drive Shaft; 0.050 lbmass; 18T XL Pulley; 0.021 lbmass; Printed ABS; Roller Middle Shaft; 0.048 lbmass

Rev 2: Added Roller shaft and roller drive shaft parts,

updated pivot arm drawing

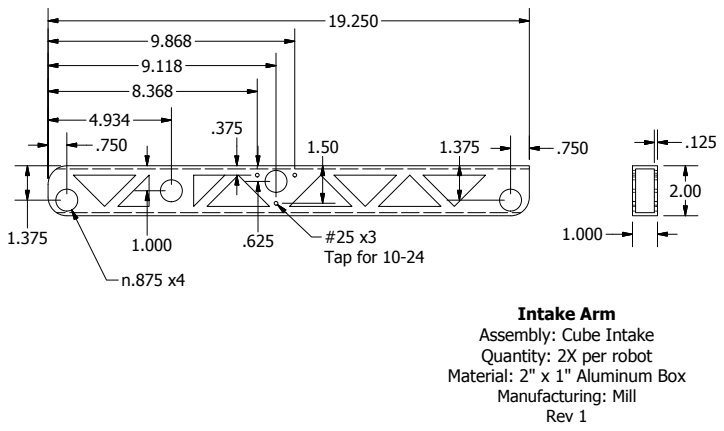
[picture p80: page 16]
Manufacturing: Mill Rev 1; #25 x3 Tap for 10-24

Intake Arm
Assembly: Cube Intake
Quantity: 2X per robot
Material: 2" x 1" Aluminum Box

#7 tap for 1/4-20

Drill for Right Hand

Drill For Left Hand

Pivot Arm
Assembly: Cube Intake
Quantity: One each RH, LH
Material: 1" Aluminum Box
Manufacturing: Mill

Rev 2: Added missing hole dimensions

12.25

1.00

1.00

.063

Cross Brace
Assembly: Cube Intake
Quantity: 2X per robot
Material: 1" Aluminum Box
Manufacturing: Mill
Rev 1


Rest Plate
Assembly: Cube Intake
Quantity: 1X per robot
Material: 1/8" Polycarbonate Plate Manufacturing: CNC
Rev 1


Motor Mount
Assembly: Cube Intake
Quantity: 2X per robot
Material: 1/4" Aluminum Plate Manufacturing: CNC
Rev 1

Rivet Plate Assembly: Cube Intake Quantity: 4X per robot Material: 1/8" Aluminum Plate Manufacturing: CNC Rev 1; Clamp and drill through 1/8" for 1/8" rivets
drill #25 tap for 10-24 X2; Manufacturing: Lathe Rev 1

Roller Shaft
Assembly: Cube Intake
Quantity: 2X per robot
Material: 1/2" Aluminum Hex Shaft

Manufacturing: Lathe Rev 1; drill #25 tap for 10-24 X2

Roller Drive Shaft
Assembly: Cube Intake
Quantity: 2X per robot
Material: 1/2" Aluminum Hex Shaft

Manufacturing: Lathe Rev 1; #25 drill tap for 10-24 X2

Roller Middle Shaft
Assembly: Cube Intake
Quantity: 2X per robot
Material: 1/2" Aluminum Hex Shaft
