YCSRobotics/CAD-66-ROBOT-2018/DXFs for WaterJet/.125PlateLayout.pdf

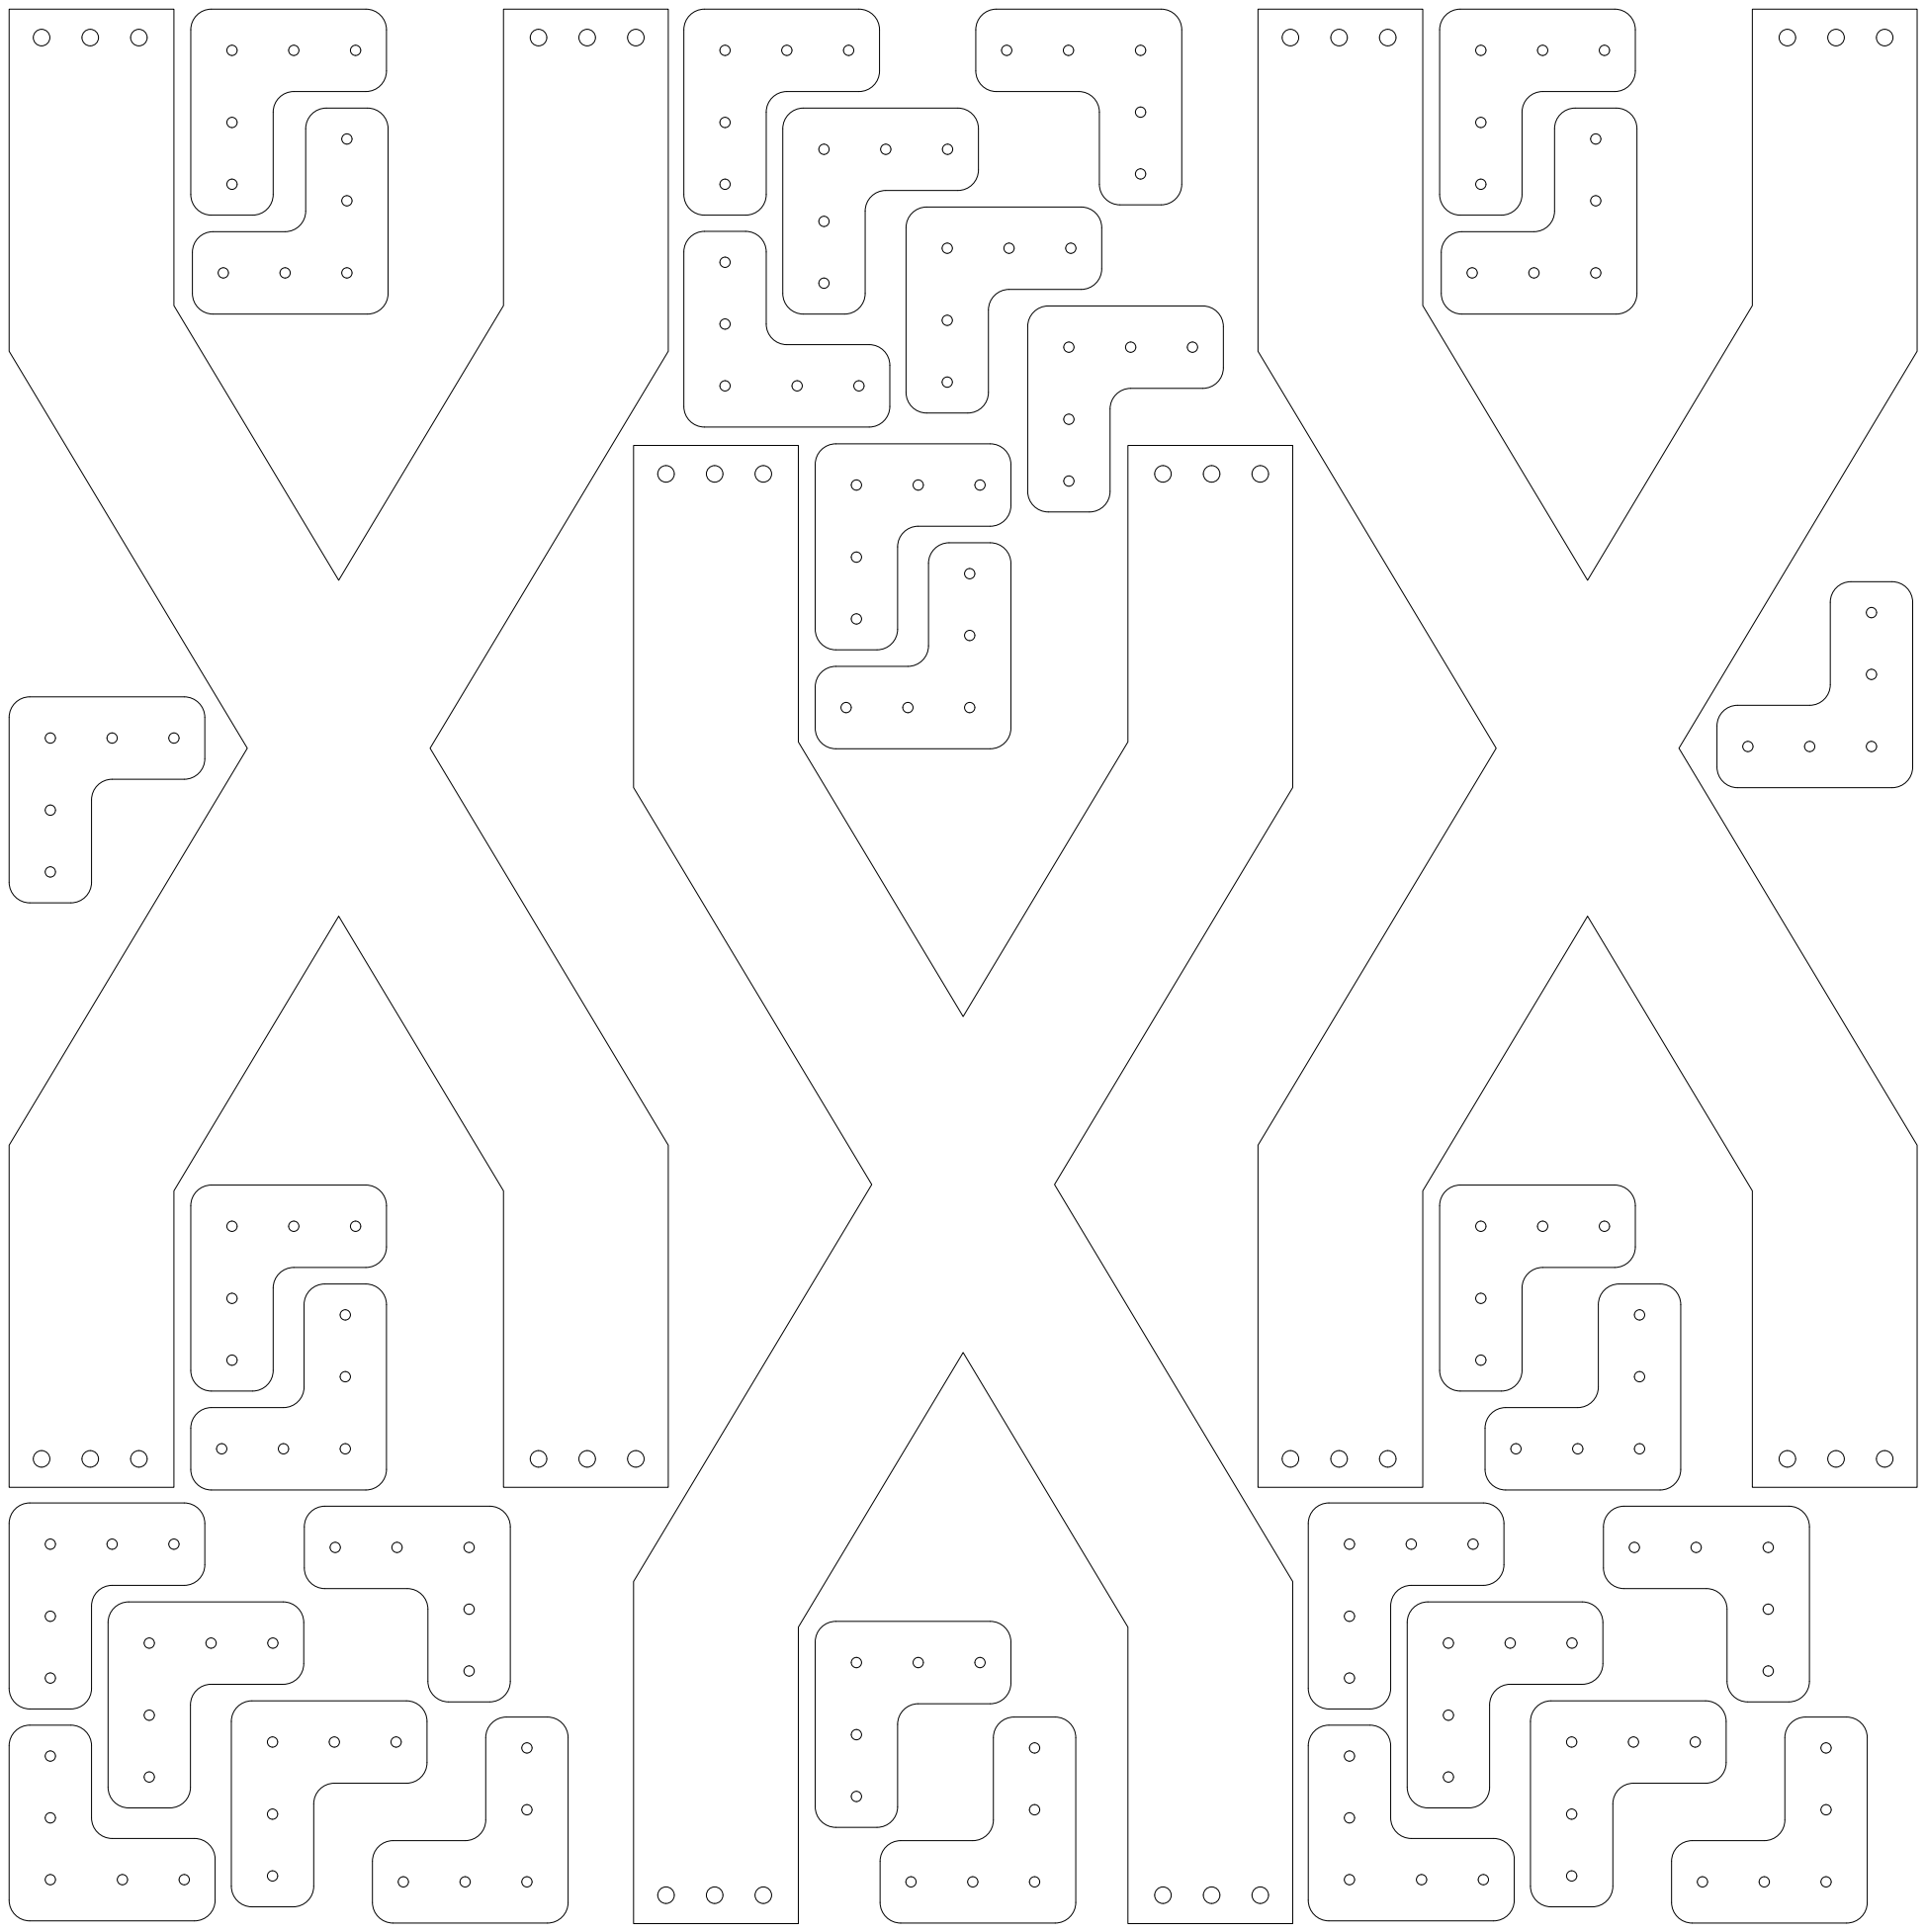
[picture p81: page 1]
