YCSRobotics/CAD-66-ROBOT-2018/DXFs for WaterJet/.25PlateLayout.pdf

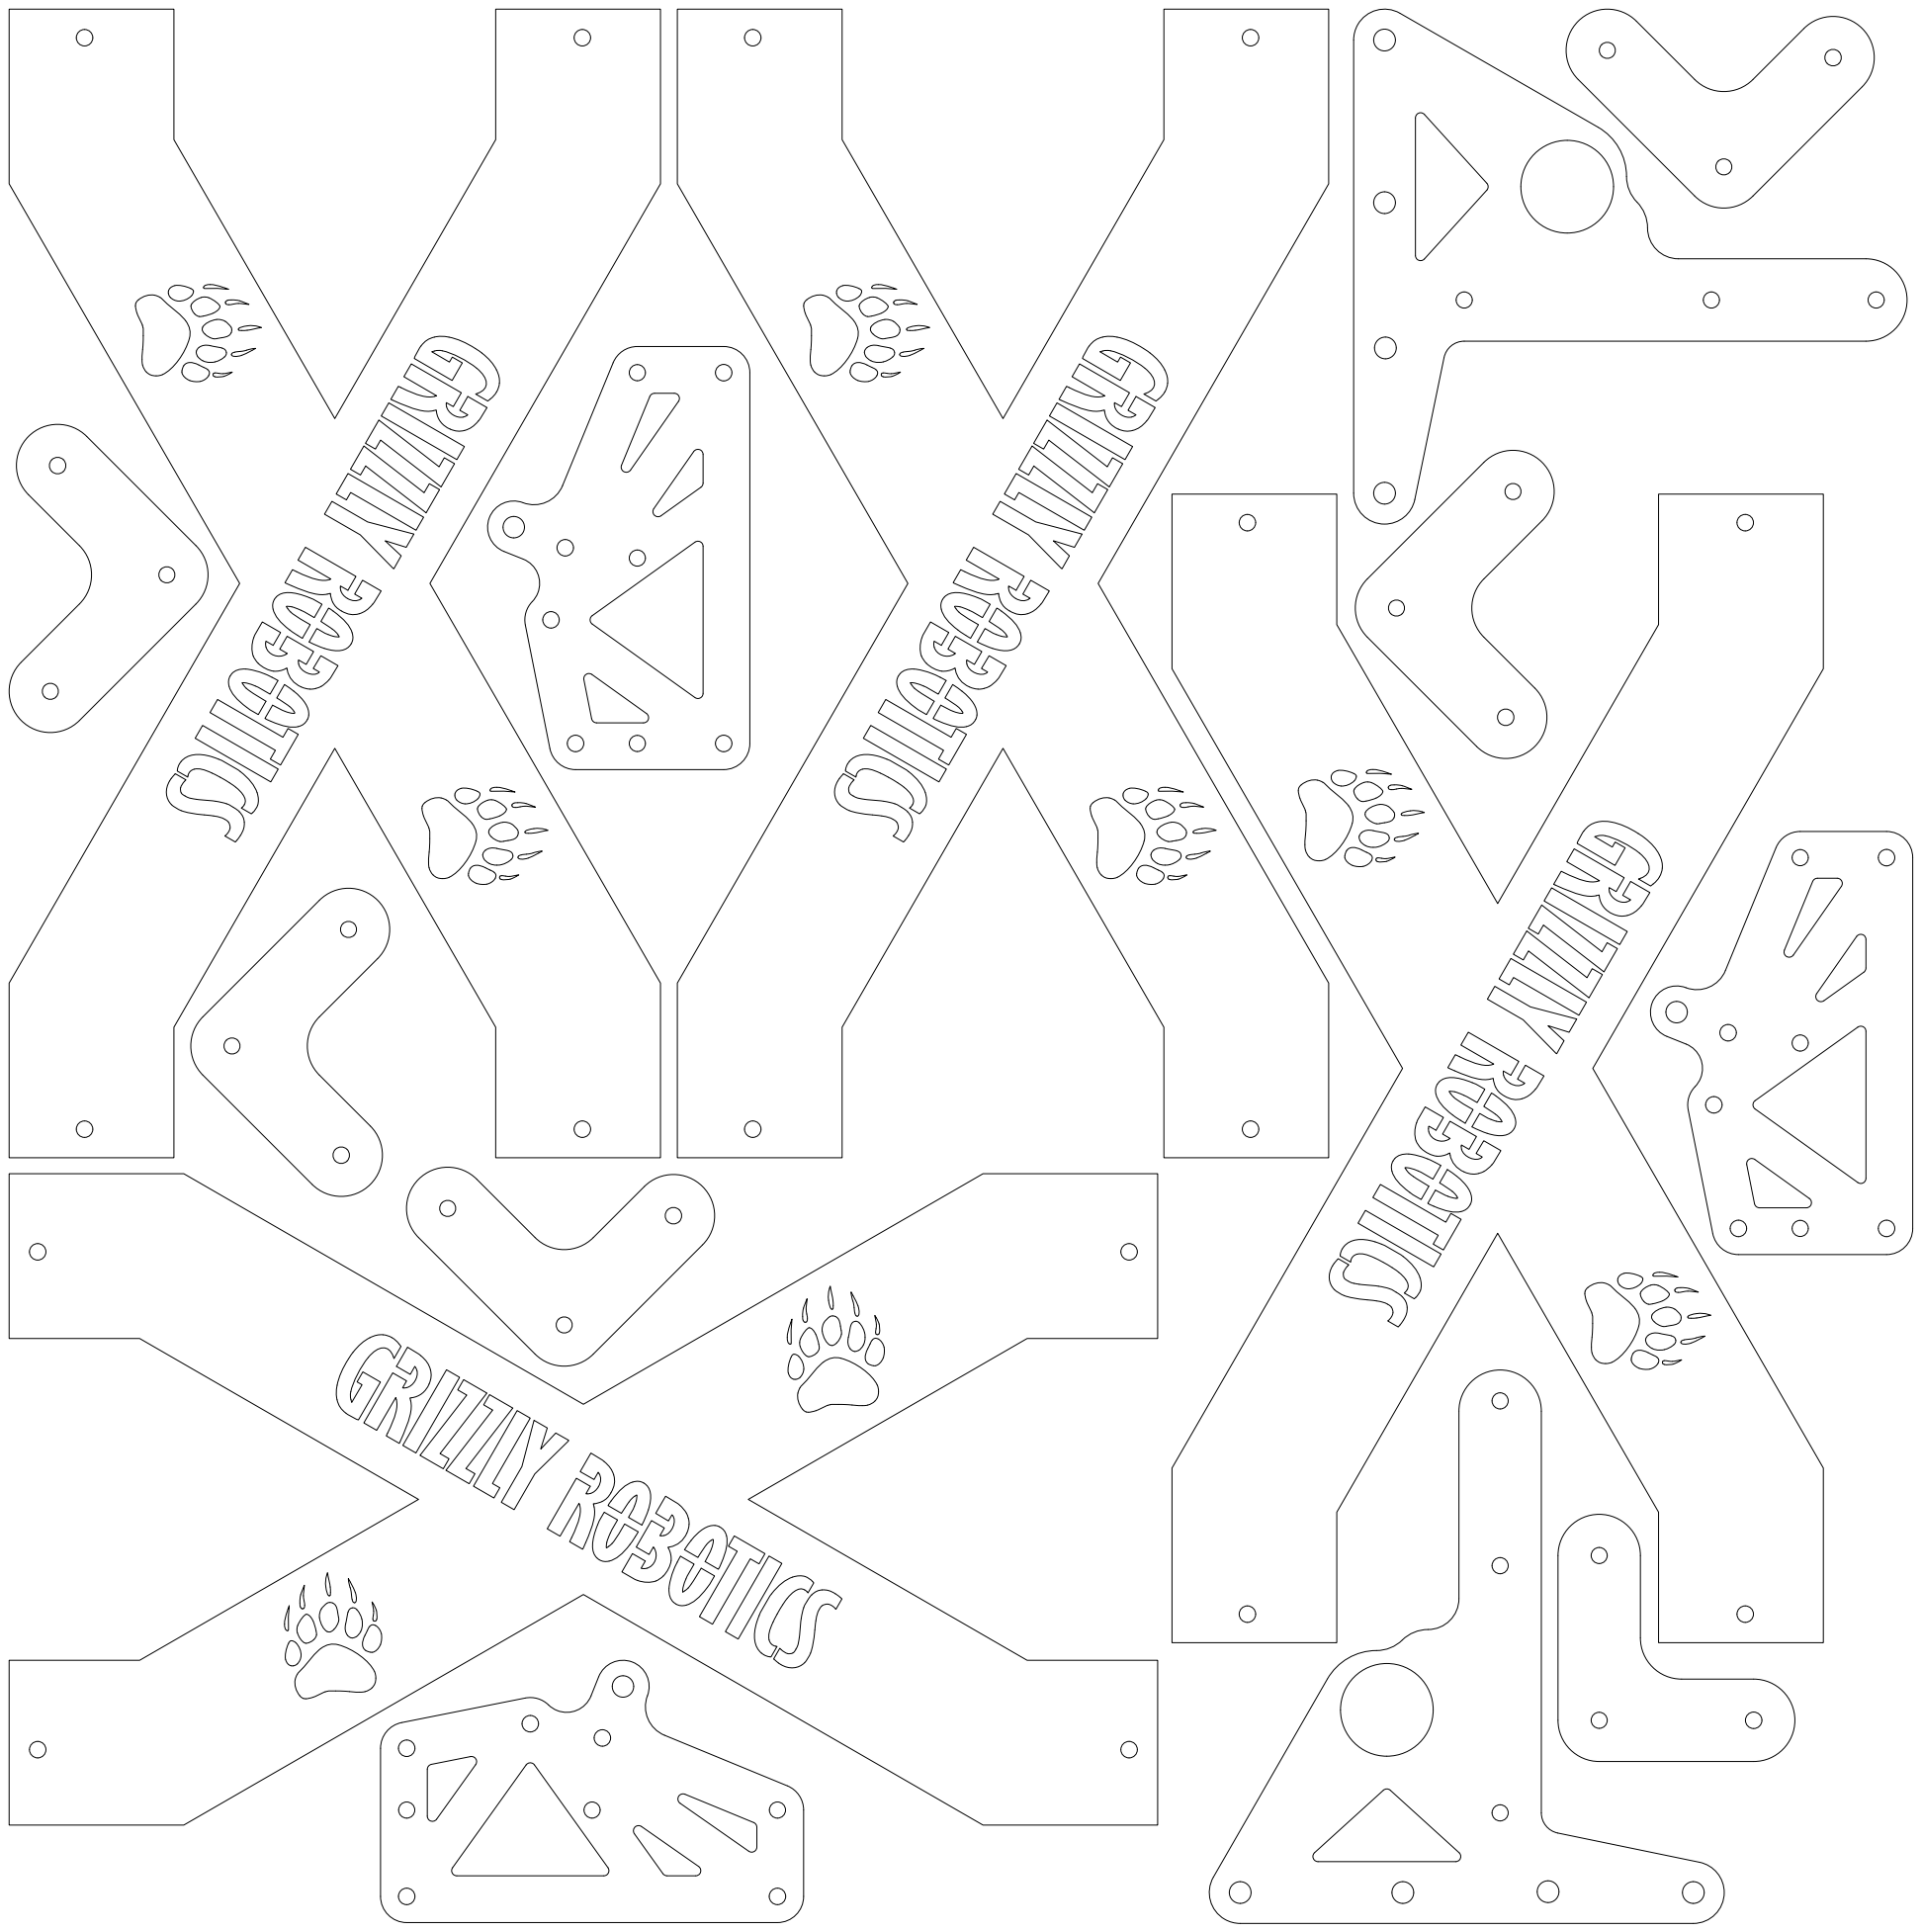
[picture p82: page 1]

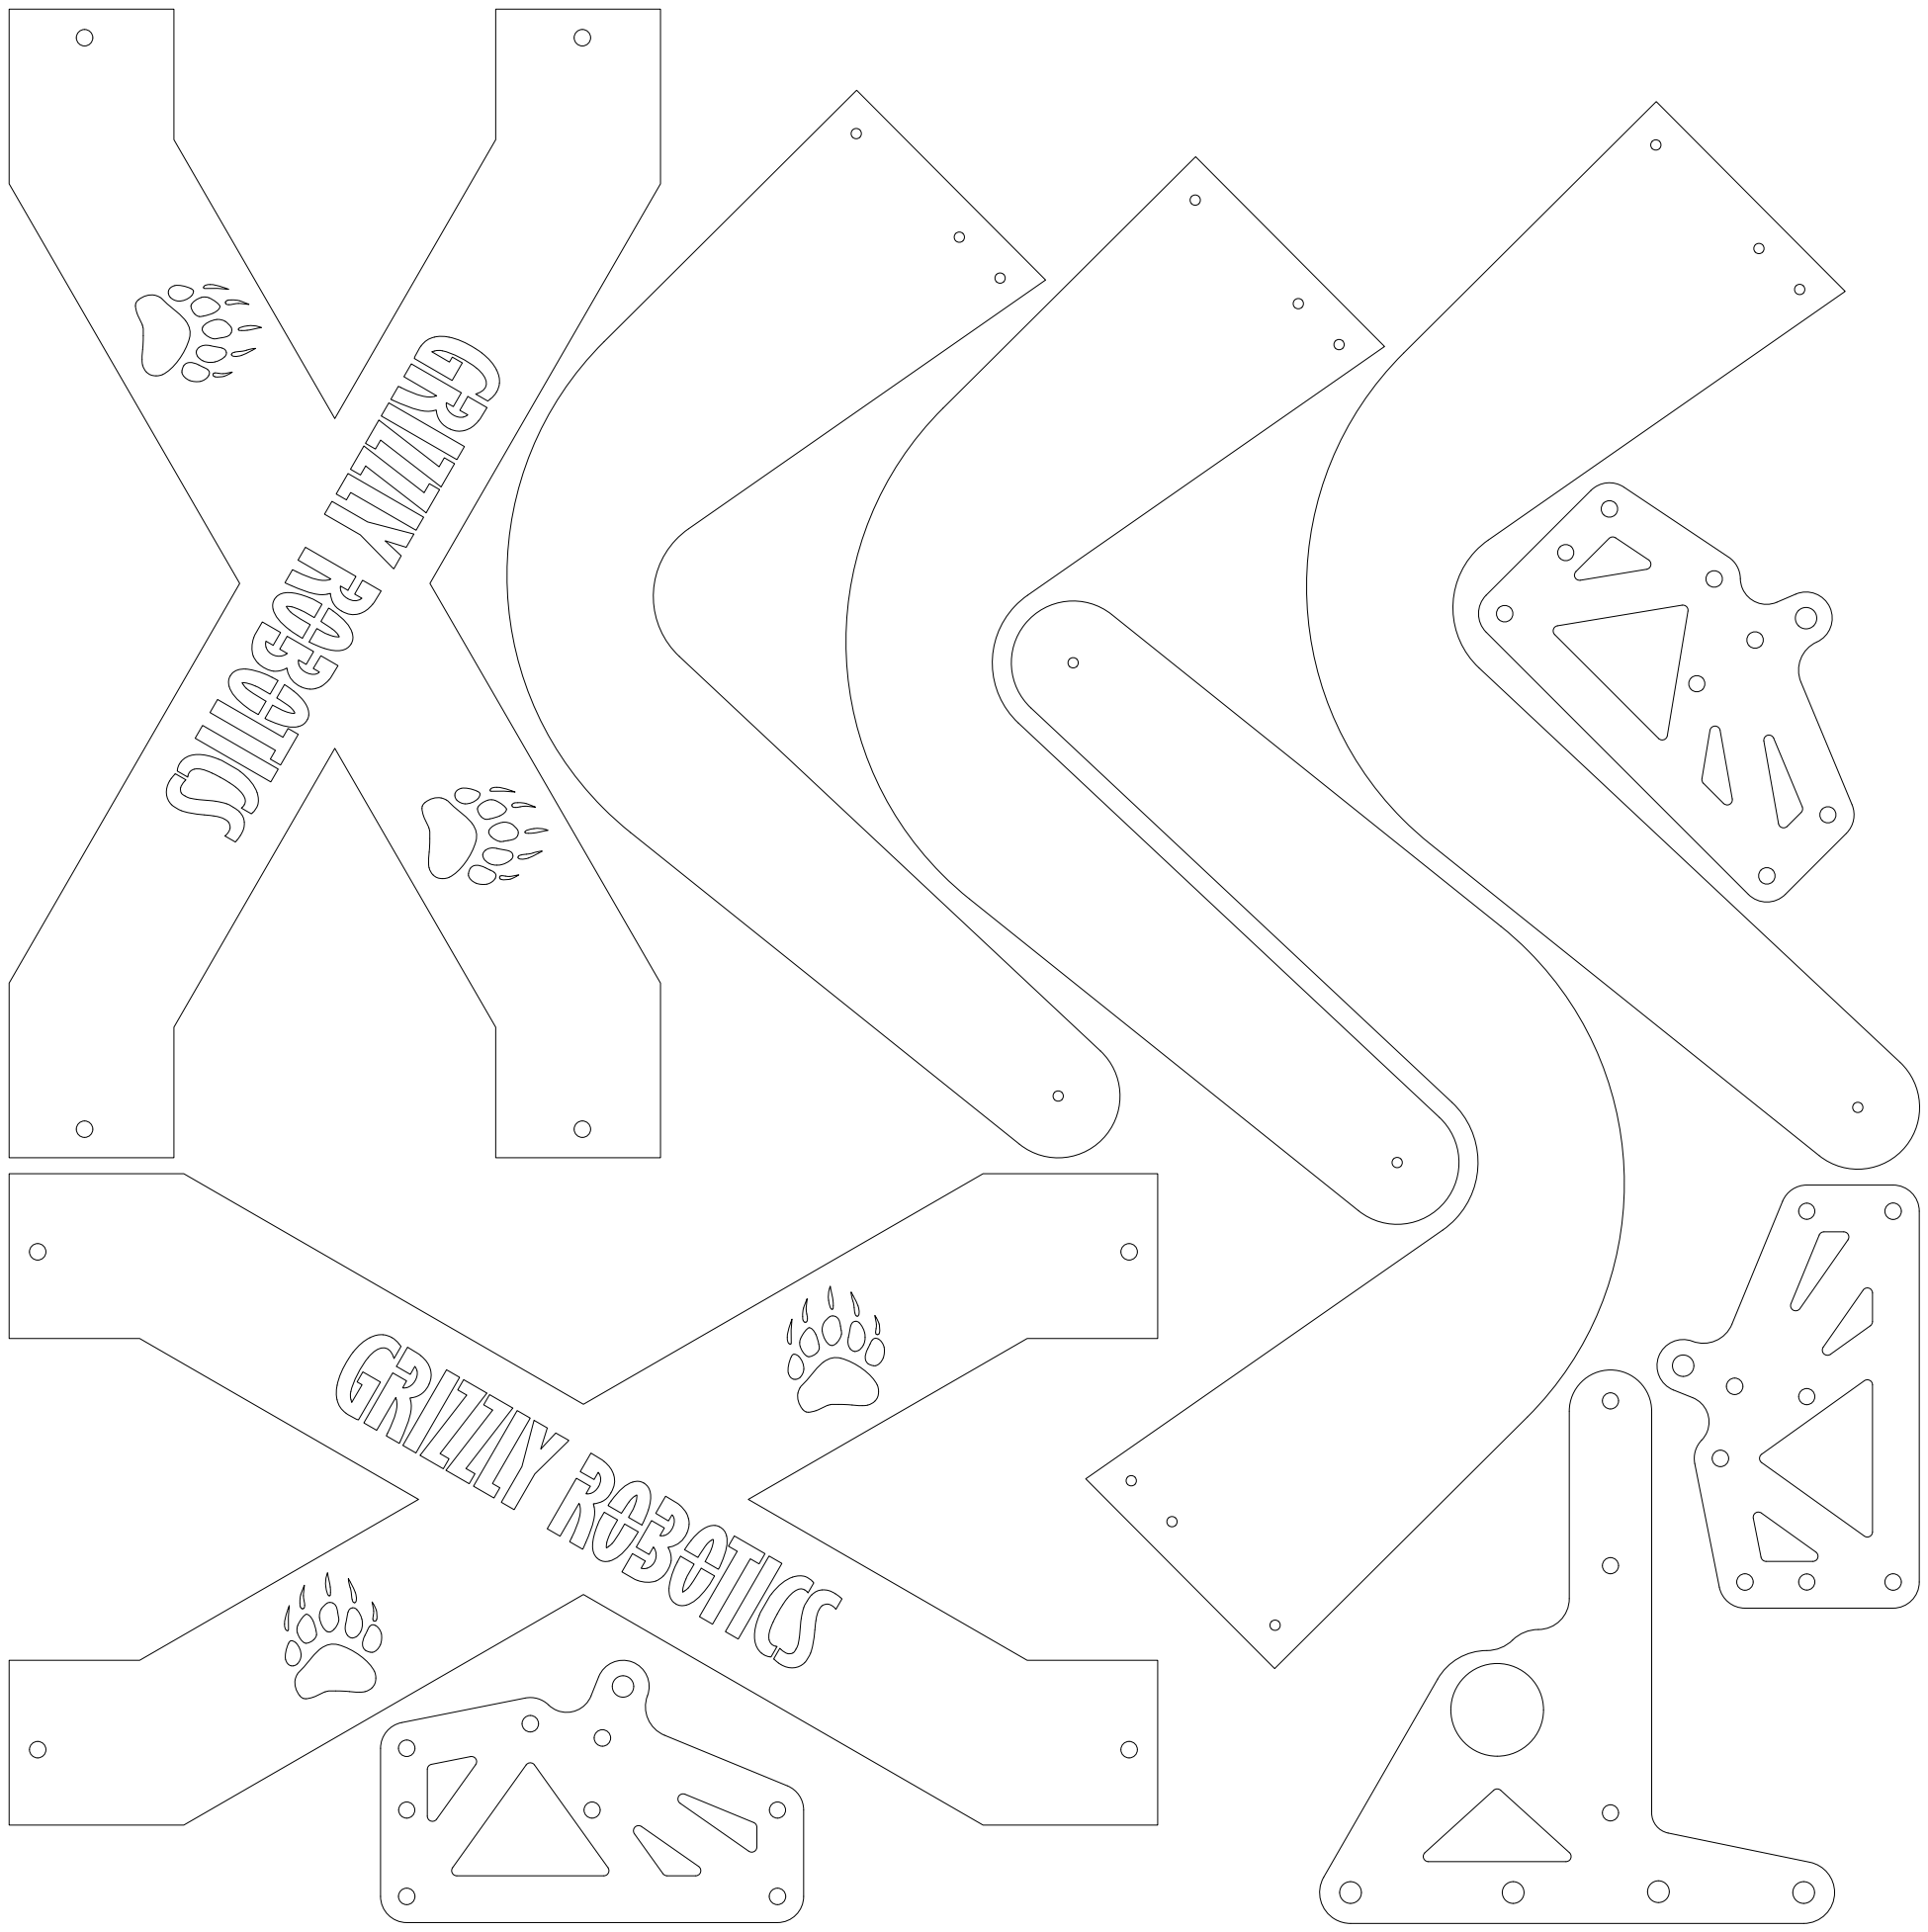
[picture p83: page 2]

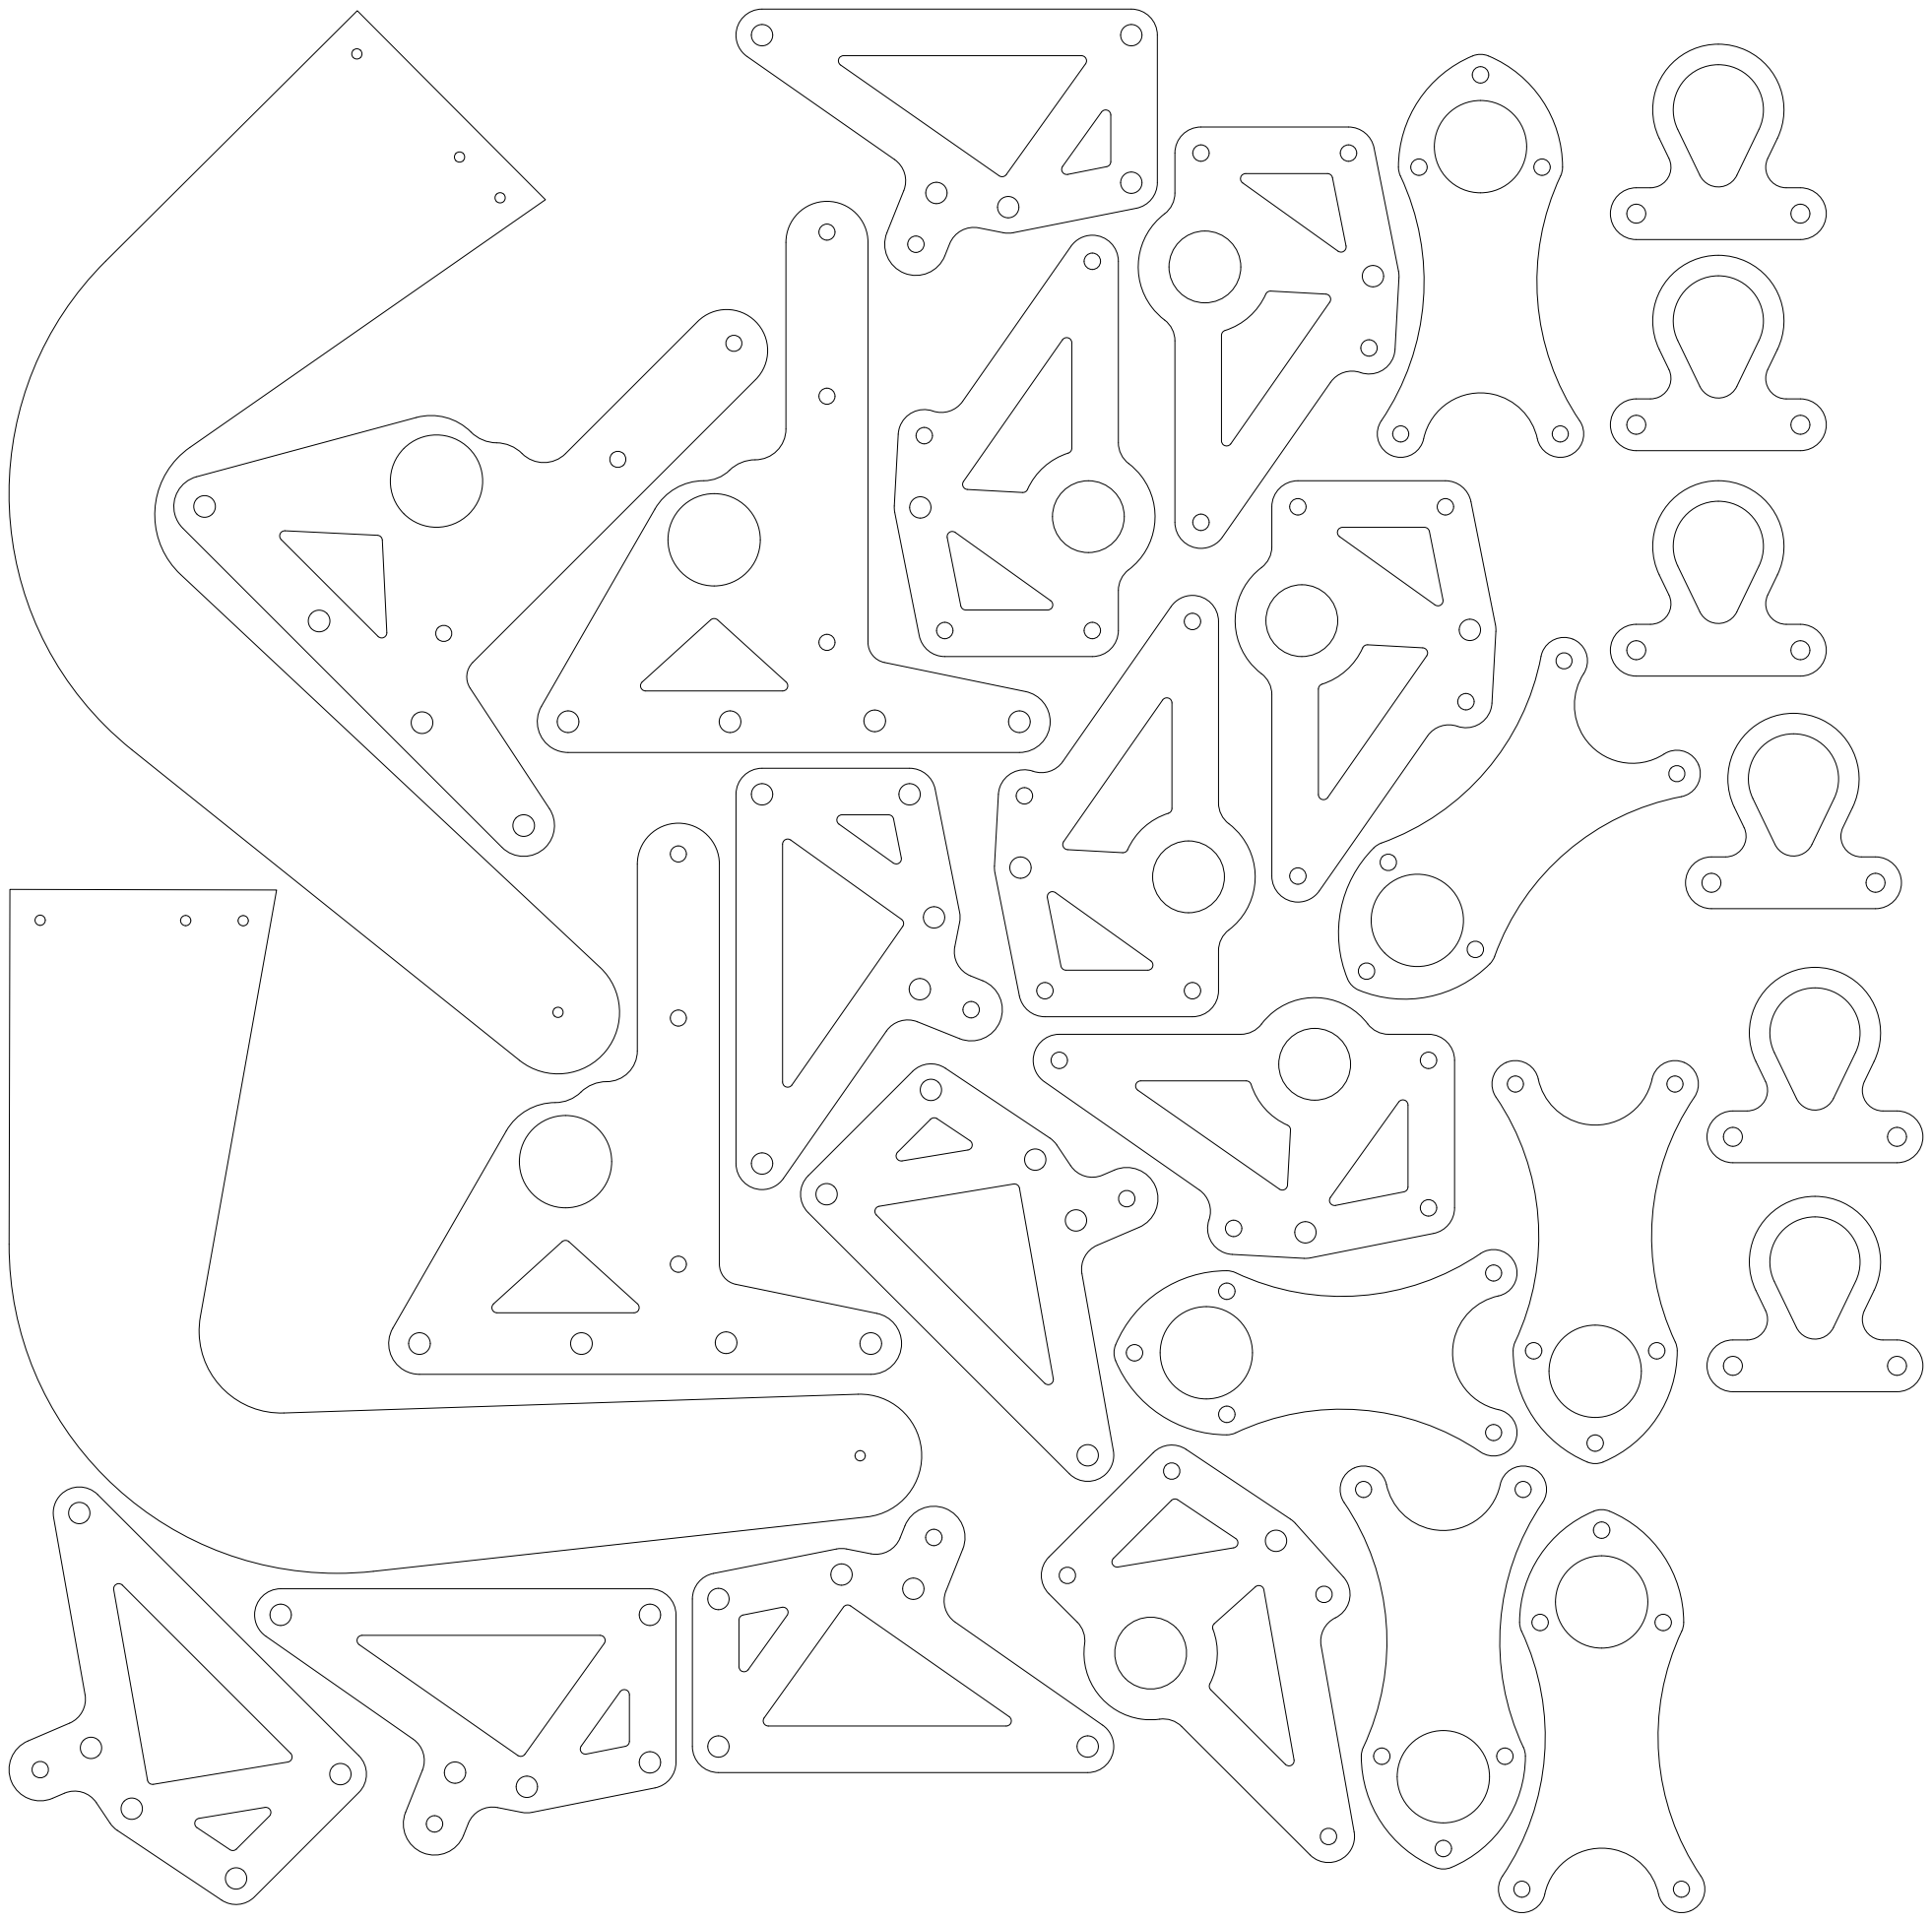
[picture p84: page 3]
