YCSRobotics/CAD-66-ROBOT-2018/(commit log)

2018-01-20 SlideWheel
    Slide wheel assembly w/o hinge.
2018-01-30 Tommy said so
    [Lift 2.0017.iam, Lift 2.0020.iam, Lift 2.iam, Part69.ipt, carriage plate for intake.0012.ipt, carriage plate for intake.0014.ipt, carriage plate for intake.ipt, carriage plate square 2.0009.ipt]
2018-01-30 End of day. Elevator is done.
    [1277N450_CORROSION-RESISTANT TIMING BELT PULLEY.STEP, 1277N450_CORROSION-RESISTANT TIMING BELT PULLEY.ipt, Intake 2.0002.iam, Intake 2.iam, Intake.iam, Lift 2.0020.iam, Lift 2.0024.iam, Lift 2.iam]
2018-01-30 Part Files Exported
    [1277N450_CORROSION-RESISTANT TIMING BELT PULLEY.0001.ipt, 1277N450_CORROSION-RESISTANT TIMING BELT PULLEY.ipt, 15t hex 3.8 shaft short.ipt, 15t hex 3.8 shaft.0001.ipt, 15t hex 3.8 shaft.ipt, Box intake geometry 2.0003.ipt, Box intake geometry 2.0004.ipt, Box intake geometry 2.ipt]
2018-01-31 hole
    Bearing Holle Diameter Fixed
    [support plate 2.ipt]
2018-01-31 Hole Sizes
    [support plate 2.0008.ipt, support plate 2.0011.ipt, support plate 2.ipt]
2018-01-31 Fillet Cut outs
    [Inside Plate.dxf, Middle Plate.dxf, Outside Plate.dxf, Support Plate.dxf]
2018-01-31 Waterjet Layout
    Some minor changes to parts before laying out.
    [.125 plate-base perimeter.ipt, .125PlatesSheet1.dxf, .125PlatesSheet2.dxf, .25PlatesSheet1.dxf, .25PlatesSheet2.dxf, .25PlatesSheet3.dxf, RobotLiftBottomXPlate.dxf, RobotLiftHinge.dxf]
2018-01-31 Correct Hinge plate
    [.25PlatesSheet1.dxf, .25PlatesSheet2.dxf, .25PlatesSheet3.dxf, LiftingEye.dxf]
2018-01-31 No lifting Eye
    [.25PlatesSheet1.dxf, .25PlatesSheet2.dxf, .25PlatesSheet3.dxf]
2018-01-31 Extra Gussets
    [.125PlatesSheet1.dxf, .125PlatesSheet2.dxf]
2018-01-31 Eye hook..
    [.25PlatesSheet3.dxf]
2018-01-31 correct hinge
2018-02-02 Updated parts and STEP files
    [1277N450_CORROSION-RESISTANT TIMING BELT PULLEY.0001.ipt, 1277N450_CORROSION-RESISTANT TIMING BELT PULLEY.ipt, 15t hex 3.8 shaft short.ipt, 15t hex 3.8 shaft.0001.ipt, 15t hex 3.8 shaft.ipt, Elevator Base.0002.iam, Elevator Base.0003.iam, Elevator Base.iam]
2018-02-03 Todays updated parts and drawings.
    [18T XL Pulley.0003.ipt, 18T XL Pulley.0004.ipt, 18T XL Pulley.STEP, 18T XL Pulley.ipt, 217-2625-003 Rev1.ipt, 217-2625-005 Rev1_Planet_Revolving_Follower01.ipt, 217-2625-007 Rev1_Public.ipt, 217-2625-008 Rev1.ipt]
2018-02-03 Exported DXF for intake arms
    [Intake Arm.dxf, arm.0017.ipt, arm.0018.ipt, arm.ipt]
2018-02-04 Newest update
    [Intake 2.0017.iam, Intake 2.0018.iam, Intake 2.iam, Lift 2.0009.iam, Lift 2.0010.iam, Lift 2.iam, Part69.0004.ipt, Part69.0005.ipt]
2018-02-06 Added assembly dimensions
    [Part Drawings.0025.dwg, Part Drawings.0027.dwg, Part Drawings.dwg]
2018-02-07 Push Update Again for taday
    [1277N450_CORROSION-RESISTANT TIMING BELT PULLEY.0001.ipt, 1277N450_CORROSION-RESISTANT TIMING BELT PULLEY.ipt, 15t hex 3.8 shaft short.ipt, 15t hex 3.8 shaft.0001.ipt, 15t hex 3.8 shaft.ipt, 1in Box Tube.ipt, First Stage Anchor.dxf, Front lift arm cross.0002.ipt]
2018-02-08 Updated intake stuffs
    [1277N450_CORROSION-RESISTANT TIMING BELT PULLEY.0001.ipt, 1277N450_CORROSION-RESISTANT TIMING BELT PULLEY.0003.ipt, 1277N450_CORROSION-RESISTANT TIMING BELT PULLEY.ipt, 18T XL Pulley.0004.ipt, 18T XL Pulley.0005.ipt, 18T XL Pulley.ipt, Elevator and Intake.0006.iam, Elevator and Intake.0007.iam]
2018-02-12 Entrapment Star
    Created the Entrapment star for the intake
    [Entrapment Star Wheel.SLDPRT]
2018-02-15 Undo bad stuff
    [1277N450_CORROSION-RESISTANT TIMING BELT PULLEY.0001.ipt, 1277N450_CORROSION-RESISTANT TIMING BELT PULLEY.ipt, 15t hex 3.8 shaft short.ipt, 15t hex 3.8 shaft.0001.ipt, 15t hex 3.8 shaft.ipt, 1in Box Tube.ipt, First Stage Anchor.dxf, Front lift arm cross.0002.ipt]
2018-03-07 Add files via upload
    added new lift frame asy stp. had to zip due to file size.
2018-03-28 climber update
    [.125 X plate cut.dxf, .125 plate-base perimeter.0001.ipt, .125 plate-base perimeter.ipt, .75sq extrusion-base frame cross bar.ipt, .75sq extrusion-base frame rail.ipt, .75sq extrusion-lift frame cross bar.ipt, .75sq extrusion-lift frame rail.ipt, 8020-3276-$PARTNUMBER.ipt]
